zvea/tiny-breakout/tutorials/physical-design.html

Loading the layout…

Scroll to zoom, drag to move, ← → to step/play

# Tiny Breakout physical design

From an empty die to the finished GDS

← Back Next →
