zvea/tiny-breakout/tutorials/asic-toolchain.html

# Tiny Breakout toolchain

Hover or focus a box or an underlined name for a short definition; click or press Enter for details. Escape closes the top popover.

The chart is wider than the screen; scroll it sideways.

## Glossary

Describes the flow as of November 2026: LibreLane 3.0.14 under Tiny Tapeout's sky26e action, sky130, as of commit 2c6b0f6 of tiny-breakout (https://github.com/zvea/tiny-breakout).
