zvea/tiny-breakout/(commit log)

2026-11-06 Real-time browser player; vectorize brick logic
    - sim/play: Verilator 4.x model streamed to a browser page at 60 fps
    (server runs the game, pushes RLE frames; keys sent separately so
    the frame rate is independent of SSH port-forward latency).
    Gamepad input goes through the emulated Gamepad PMOD protocol.
    - project.v: brick select / clear and row/column decoders written as
    whole-vector expressions. Same behaviour (identical output checksum),
    ~1.5x faster simulation, and the re-hardened layout shrank from
    73.4% to 70.5% utilization with no typical-corner slew violations.
    - .gitignore: simulator build output, local toolchains, GDS renders.
2026-11-06 Fix autoplay getting stuck in a closed ball loop
    Autoplay always aimed the ball at the paddle centre, so the bounce angle
    never varied and the ball could settle into a repeating path that missed
    the remaining bricks. Now each paddle hit picks one of four 16 px paddle
    zones from a 5-bit LFSR, which varies the return angle.
    Add sim/play/autoplay_check.cpp: long autoplay run reporting bricks
    cleared, levels and lives lost (30k frames: 2 levels, 0 lives lost).
    Layout: 74.0% utilization, all timing/DRC/LVS/antenna checks clean.
    [project.v]
2026-11-06 Name the magic numbers in the RTL
    Replace bare constants with named localparams: VGA timing (H_*/V_*),
    gamepad button bit positions (GP_*), paddle limits and serve position,
    spare lives, and a colour palette with per-object colour roles.
    Formally equivalent to the previous version (yosys equiv: 355/355
    proven). Synthesis area drops slightly (7726 -> 7714 um^2) because the
    vsync test is now a range compare.
    [project.v]
2026-11-06 Convert the RTL to SystemVerilog
    Rename src/project.v to src/tt_um_tiny_breakout.sv (file named after
    its module) and update info.yaml, test/Makefile and the player build.
    - logic for all variables and ports (reg did not mean "register")
    - always_ff for flip-flops, always_comb for combinational blocks
    - constants sized to the signals they are compared with, so the RTL is
    Verilator -Wall clean; unused bits listed in _unused
    - '1 fill for the gamepad shift register reset
    - wire kept for one-line continuous definitions: "logic x = expr;"
    would be a one-time initialiser
    ALL_BRICKS keeps {48{1'b1}}: yosys's built-in frontend sizes '1 in a
    parameter as a single bit, which the equivalence che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
    [tt_um_tiny_breakout.sv]
2026-11-06 Clearer names and a gamepad button struct
    - hc/vc -> h_pos/v_pos (beam position), with a comment on their ranges
    - hsync_n/vsync_n -> h_sync_n/v_sync_n, hs_q/vs_q -> h_sync_q/v_sync_q
    - Replace the GP_* bit-position constants with a packed struct naming all
    12 buttons in the order the PMOD sends them; list the 7 unused buttons
    in _unused
    - Slice the brick row into vb_low outside the always_comb, which silences
    Icarus's "constant selects in always_* processes" note
    Formally equivalent to the previous version with the renames applied
    (yosys equiv: 355/355 proven); identical synthesis result (7749 um^2,
    1008 cells). Verilator -Wall clean; cocotb tests pass.
    [sim.h, test.py, tt_um_tiny_breakout.sv]
2026-11-06 Describe the pin layouts with packed structs
    - inputs_t names the ui_in pins (direct buttons, autoplay, Gamepad PMOD);
    the code reads ui.left, ui.gp_data etc. instead of ui_in[N]. A comment
    cites the Gamepad PMOD's default pinout for the fixed bits 4..6.
    - tiny_vga_t names the TinyVGA PMOD pins; uo_out is wired field by field
    with continuous assigns (inside always_comb, Icarus treats struct
    fields as part-selects and warns).
    - rgb_t {r, g, b} for the palette, rgb, brick_rgb and rgb_q.
    - Header pin list in bit order, pointing at the structs.
    Formally equivalent to the previous version (yosys equiv: 370/370
    proven); identical synthesis result (7749 um^2, 1008 cells).
    Verilator -Wall c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
    [tt_um_tiny_breakout.sv]
2026-11-06 Simplify gamepad edge detection
    The *_prev registers were a third stage of the clock/latch synchronisers:
    widen gp_clk_s and gp_latch_s to 3 bits and name the edge conditions
    gp_clk_rise and gp_latch_rise.
    Formally equivalent to the previous version (yosys equiv: 380/380
    proven); same flip-flops. Verilator -Wall clean; cocotb tests pass.
    [tt_um_tiny_breakout.sv]
2026-11-06 Round ball and spare-life markers
    A shared function in_circle8 cuts the corners of an 8x8 box into an
    8-px circle (rows 4, 6, 8, 8, 8, 8, 6, 4 px wide). The ball and the
    spare-life markers both use it; collisions follow the round ball shape
    since they are detected by pixel overlap.
    The function assigns its result to its name instead of using "return",
    which the yosys 0.55 frontend does not support.
    Cost: synthesis 7721 -> 7911 um^2 (+14 cells); layout utilization
    74.0% -> 76.1%, all timing/DRC/LVS/antenna/slew checks clean.
    Verilator -Wall clean; cocotb tests pass; rendered frame checked.
    [tt_um_tiny_breakout.sv]
2026-11-06 Group collision flags, loop the brick decoder, name the 8-px grid
    - hit_l/r/t/b/p -> packed struct hit (hit.l, hit.p, ...), cleared with
    a single hit <= '0
    - brick_sel built by a generate loop instead of six copy-pasted terms
    - cell_x/cell_y plus WALL_L_CELL, WALL_R_CELL, WALL_T_CELL,
    PADDLE_CELL_Y and LIVES_CELL_Y replace the bare h_pos[9:3]/v_pos[9:3]
    comparisons; hb/vb -> brick_col/brick_row
    - Drop the redundant autoplay alias; use ui.autoplay directly
    Formally equivalent to the previous version with the hit-flag rename
    applied (yosys equiv: 374/374 proven). Verilator -Wall clean; cocotb
    tests pass.
    [tt_um_tiny_breakout.sv]
2026-11-06 Show spare-life marker i while lives > i
    Replace the two hand-written slot tests with life_slot < lives, where
    life_slot counts 16-px slots from FIRST_LIFE_SLOT (x 64). Raising
    SPARE_LIVES now shows more markers with no other change.
    Verified: equivalent to the previous version everywhere except life_px
    (yosys equiv: 400/401), and a separate SAT proof shows the old and new
    marker tests agree for every h_pos when lives <= 2 (the only reachable
    values; without that assumption the proof fails at lives = 3, x = 96).
    Synthesis +16 um^2 (+3 cells). Verilator -Wall clean; cocotb tests pass.
    [tt_um_tiny_breakout.sv]
2026-11-06 Split the game logic into one block per concern
    Name the per-frame decisions once, in priority order (restart,
    on_paddle, lose_ball, fly) plus touch for scan-out contact, and split
    the single game always_ff into paddle, ball, game progress, bricks and
    collision-flag blocks so each register is written in exactly one place.
    Formally equivalent to the previous version (yosys equiv: 407/407
    proven), so the original priority order is preserved. Verilator -Wall
    clean; cocotb tests pass.
    [tt_um_tiny_breakout.sv]
2026-11-06 Name the ball direction flags for what they mean
    vx_neg/vx_fast/vy_neg -> ball_left/ball_steep/ball_up, the next-state
    wires to next_left/next_steep/next_up/paddle_left, and the per-frame
    steps vx/vy to step_x/step_y. A comment explains why the direction is
    kept as sign and magnitude: it matches how walls, paddle and bricks
    change it. Storing two's-complement velocities instead was tried: same
    behaviour (6000 autoplay frames identical) but +464 um^2 (+6%) of logic.
    (yosys equiv: 388/388 proven); identical synthesis result (7816 um^2,
    1033 cells). Verilator -Wall clean; cocotb tests pass.
    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
2026-11-06 Split out vga_timing and gamepad_rx modules
    - vga_timing: 640x480 @ 60 Hz counters, sync pulses, visible, and a new
    vblank_start strobe (the game's frame_tick)
    - gamepad_rx: synchronisers, edge detection and shift register; outputs
    all 12 named buttons (gamepad_pkg::gamepad_t), all zero without a
    controller. Mapping buttons to "fire" moved into the game.
    - gamepad_pkg: the shared button type. Referred to as
    gamepad_pkg::gamepad_t because the flow's yosys (0.62) does not
    support `import`.
    - ALL_BRICKS back to '1: yosys 0.62 sizes it correctly (0.55 did not).
    - Source lists updated in info.yaml (package first), test/Makefile and
    sim/play/build.sh.
    Verification: yosys equiv proves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
    [gamepad_pkg.sv, gamepad_rx.sv, tt_um_tiny_breakout.sv, vga_timing.sv]
2026-11-06 Add unit tests for vga_timing and gamepad_rx
    cocotb tests run per module through the cocotb runner and pytest:
    pytest test/unit # Verilator (default), ~30 s
    SIM=icarus pytest test/unit # Icarus, as in the Tiny Tapeout CI, ~75 s
    vga_timing: sync pulse widths and periods with their start positions,
    the 640 x 480 visible area, and the vblank_start strobe.
    gamepad_rx: reset state, each button's field, second controller
    ignored, absent controller reads as nothing pressed, outputs change
    only on the latch pulse.
    The frame-level VGA tests wait on signal edges instead of stepping the
    clock from Python. Both simulators pass.
    [cocotb_run.py, test_gamepad_rx.py, test_vga_timing.py]
2026-11-06 Split out the autoplay module, with unit tests
    autoplay holds the LFSR, the aim zone and the steering comparison. Its
    interface takes the ball and paddle x positions in pixels and returns
    steer_left/steer_right; the top level still decides whether autoplay or
    the buttons steer.
    Unit tests (test/unit/test_autoplay.py): steering against a reference
    formula across zones, paddle and ball positions; the zone changes only
    on paddle hits and comes from the random sequence; the sequence visits
    all 31 non-zero values with period 31; every zone gets picked.
    Formally equivalent to the previous version (yosys equiv: 443/443
    proven, registers paired across the new module boundary). Verilator
    -Wall clea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
2026-11-06 Split out the brick_wall module, with unit tests
    brick_wall holds the 48-bit brick state, the field geometry, the
    column/row decoders and the 2-px gaps. Interface: beam position,
    refill and clear in; brick_px, brick_row (0 = top .. 5), over_columns
    and empty out. The game states its brick rules in two assignments, and
    the colour table now reads top to bottom by row index.
    Unit tests (test/unit/test_brick_wall.py): full wall with correct rows
    after reset; gaps and surroundings are not bricks; clearing removes
    exactly the brick under the beam (checked against a model); empty after
    the last brick, then refill; over_columns spans x 64..575.
    Formally equivalent to the previous version (yosys eq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
    [brick_wall.sv, test_brick_wall.py, tt_um_tiny_breakout.sv]
2026-11-06 Reduce area: indexed brick read, shared wall tests, 3-signal gamepad latch
    Measured with the Tiny Tapeout default flow (config untouched); TT
    utilisation 75.33% -> 74.03%.
    - brick_wall: read the brick under the beam by binary index
    ({row, col}) instead of the 48-way one-hot AND-OR.
    - The top wall spans the left wall, the brick columns and the right
    wall, so it reuses those tests instead of two range comparators.
    - gamepad_rx now outputs the report with a one-clock report_valid
    strobe; the game latches only its 3 controls (left, right, fire =
    B | start | A) instead of the receiver latching 5 buttons.
    Tried and rejected (measured worse or no gain): life markers as two
    equality tests,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
2026-11-06 Reorder and rename the top level for clarity
    Sections now follow the data flow: types and pins, video timing, game
    state, controls, what is under the beam, collisions, frame update,
    video output. rgb_t moves to the types; button combining sits with the
    gamepad latch and autoplay.
    Renames for consistency: bx/by -> ball_x/ball_y; pad_q/padx/PAD_*_Q ->
    paddle_q/paddle_x/PADDLE_*_Q; dbx/dby/dpx -> ball_dx/ball_dy/paddle_dx;
    hit.l/r/t/b/p -> hit.wall_l/wall_r/wall_t/brick/paddle; hit_zone ->
    hit_quarter and autoplay's zone -> aim_quarter; serve -> serving;
    gameover -> game_over; wall_*/field -> wall_*_px/field_px (plus
    wall_px); ap_* -> auto_*; paddle_left -> left_after_paddle.
    brick_wall comput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
    [autoplay.sv, brick_wall.sv, test_autoplay.py, tt_um_tiny_breakout.sv]
2026-11-06 Replace white-box sim tools with black-box scenario tests
    test/system/scenarios.cpp drives only the input pins and judges only
    from the decoded video output (life markers, ball, paddle, bricks), so
    RTL refactors cannot break it. Scenarios: launch, steering (direct pins
    and gamepad), paddle limits, game over and restart, autoplay clears a
    level. test_scenarios.py builds it with Verilator (sources from
    info.yaml) and runs each scenario under pytest: pytest test/system
    (about 5 minutes, mostly the autoplay level).
    sim/play/sim.h can now drive the direct button pins.
    Removed sim/harness.cpp (CXXRTL) and sim/play/autoplay_check.cpp: both
    read internal signals by name and had been broken since t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
    [sim.h]
2026-11-06 Split out the tiny_vga_out module, with unit tests
    tiny_vga_out owns the TinyVGA PMOD facts: the pin layout, registering
    all 8 outputs on the same clock edge, and blanking (black outside the
    visible area, which the game's colour priority no longer handles). Its
    colour inputs are three plain 2-bit ports, so it depends on no package
    and can be reused as is.
    Unit tests (test/unit/test_tiny_vga_out.py): all 64 colours land on the
    right pins; blanking forces black while syncs pass through; all sync
    combinations pass through; outputs change one clock after the inputs.
    Formally equivalent to the previous version at every output pin and
    register (yosys equiv: 527/533; the 6 unproven points are the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
    [test_tiny_vga_out.py, tiny_vga_out.sv, tt_um_tiny_breakout.sv]
2026-11-06 Move the colour type and palette into colour_pkg
    colour_pkg holds rgb_t (2 bits per channel) and the 11 named colours.
    tiny_vga_out takes a single colour_pkg::rgb_t port instead of r, g, b,
    so the channels cannot be swapped at the instance. The top level keeps
    only what is the game's: the colour roles, the brick-row colours and
    the drawing priority.
    Formally equivalent to the previous version (yosys equiv: 554/554
    proven); identical synthesis result. Verilator -Wall clean;
    tiny_vga_out unit test passes.
    [colour_pkg.sv, test_tiny_vga_out.py, tiny_vga_out.sv, tt_um_tiny_breakout.sv]
2026-11-06 Speed the ball up as it reaches higher brick rows
    speed_level (0..3) rises to the level of the highest brick-row pair the
    ball has cleared a brick in (rows 4-5, 2-3, 0-1 -> 1, 2, 3: the
    inverted top two bits of brick_row) and returns to 0 whenever the ball
    is back on the paddle (new ball, level or game). On average
    speed_level frames in 4 the ball moves twice its step (a shift), giving
    1x, 1.25x, 1.5x, 1.75x; steps stay even and at most 4 px.
    The LFSR moved out of autoplay into a new frame_rng module, shared by
    autoplay's aim (bits 1:0) and the speed rhythm (bits 3:2). autoplay now
    takes its random bits as an input.
    Tests: autoplay unit tests drive the random input; new frame_rng unit
    test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
    [autoplay.sv, test_autoplay.py, tt_um_tiny_breakout.sv]
2026-11-06 Toggle autoplay with the gamepad's SELECT button
    Each press of SELECT (released in the previous report, pressed in this
    one) switches autoplay on or off; holding it counts as one press. The
    direct AUTOPLAY pin still works: autoplay = pin OR gamepad toggle. Two
    flip-flops: the latched SELECT and the on/off state.
    New select_toggles_autoplay scenario: holding SELECT switches autoplay
    on once (it launches the ball); a second press switches it off (the
    paddle stays put without input).
    Verified: Verilator -Wall clean. TT utilisation 75.11% -> 76.46%, more
    than two flip-flops would suggest; not yet investigated.
    Not yet run: the unit tests and the scenarios (also still pending for
    the speed-up c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
    [tt_um_tiny_breakout.sv]
2026-11-06 Faster speed-up without the LFSR; bounce off brick sides
    Speed: the ball and the paddle now move 1, 2 or 3 times per frame, by
    their usual step, at the start of lines 480, 481 and 482 (vertical
    blanking). Twice per frame after the current ball has cleared 4
    bricks, three times after 8; back to once per frame when the ball is
    on the paddle. This replaces the row-based 1x..1.75x rhythm: higher top
    speed, faster progression, even motion, and no step scaling or paddle
    clamp arithmetic.
    No more LFSR: frame_rng and its tests are gone. Autoplay moves its aim
    on by 1 or 2 paddle quarters on each paddle hit, chosen by ball_x[2].
    The paddle re-decides before every 4-px move, so it stops exactly on
    ta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
    [autoplay.sv, test_autoplay.py, tt_um_tiny_breakout.sv]
2026-11-06 Keep the brick wall as a ring that turns with the beam
    The bricks are stored in the order the beam meets them, so the brick
    under the beam is always bricks[0][0]: no 48-way read multiplexer, no
    write decoder, and clearing touches one bit. The head row turns by one
    brick at the start of each brick column (8 turns per line); all rows
    turn by one row at the start of each brick row (6 per frame). Each
    brick bit becomes a single enable flip-flop.
    Refill shifts 1s in with the row turns of the next frame, so the 48
    bits need no reset; the bricks stay hidden until the last turn (only
    the bottom row shows for that one frame), which also keeps the
    unreset bits from showing as X in simulation. Empty i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
    [brick_wall.sv, brick_wall_tb.sv, test_brick_wall.py]
2026-11-06 Trim the gamepad receiver
    - The shift register has no reset; instead the first report after
    reset is not presented (it may have started before reset ended), so
    every presented report is complete. Each shift bit is now a single
    enable flip-flop instead of a flip-flop plus reset/enable logic.
    - No controller is detected as up and down pressed together (a d-pad
    can't), instead of all 12 bits being ones.
    - report_valid is the synchronised latch level (a few clocks) rather
    than its rising edge, saving the edge-detect flip-flop. The top
    level's SELECT edge detection already ignores a held level.
    - The data synchroniser stays: the reference driver samples data at
    the same delay as the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
    [gamepad_rx.sv, test.py, test_gamepad_rx.py, tt_um_tiny_breakout.sv]
2026-11-06 Five behaviour-preserving area savings in the top level
    - Walls: whether the ball touches the left, right or top wall follows
    from its position (x <= 63, x + 7 >= 576, y <= 31: its round shape
    reaches its box's edges), checked at frame_tick like the flags were.
    Three collision flags go.
    - ball_y is always even and below 512: only y / 2 is stored (8 bits).
    - Game over is lives == 3: losing a ball with none left wraps lives
    from 0 to 3. The game_over flip-flop goes.
    - Life markers sit in two fixed slots instead of a slot subtraction
    and comparison.
    - The speed counter stops when bit 3 is set (8) instead of comparing.
    Measured in local synthesis (sky130, mean of 5 register orderings)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
    [tt_um_tiny_breakout.sv]
2026-11-06 Add half speed steps: 1x, 1.5x, 2x, 2.5x, 3x
    The speed still goes up every 4 bricks the current ball clears, now by
    half a step: 1x, 1.5x, 2x, 2.5x, then 3x after 16 bricks. A half step
    alternates frames (1.5x: 1, 2, 1, 2 ... moves per frame; 2.5x: 2, 3),
    using a new odd_frame flip-flop:
    moves = 1 + speed_level[4:3] + (speed_level[2] & odd_frame)
    speed_level grows to 5 bits and stops at 16. At most 3 moves per frame
    as before, so collisions and the blanking-line timing are unchanged.
    ball_speeds_up checks every step: 2, 2|4, 4, 4|6 and 6 px per frame
    vertically, the half steps alternating from frame to frame.
    Verified: Verilator -Wall clean; ball_speeds_up (frames checked at
    1x/1.5x/2x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
    [tt_um_tiny_breakout.sv]
2026-11-06 Add an optional score (ENABLE_SCORE, off by default)
    score: a 3-digit decimal (BCD) counter, one point per brick, shown as
    four seven-segment digits with a fixed last 0 (arcade style: a brick
    reads as 10, up to 9990), white, top right at x 512..575. It goes back
    to 0000 when a new game starts and stays visible through game over.
    It costs about 8.3 TT utilisation points (71.70% -> 80.00%, mean of 3
    orderings), so it is behind a top-level parameter, ENABLE_SCORE,
    default 0: the Tiny Tapeout wrapper builds without it, and synthesis
    then drops the module (same area as before, within a gate).
    Simulators can enable it: Verilator -GENABLE_SCORE=1, Icarus -P;
    ENABLE_SCORE=1 for sim/play/build.sh an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
    [score.sv, test_score.py, tt_um_tiny_breakout.sv]
2026-11-07 Level progression, LFSR autoplay, demo while no controller is connected
    Level cleared:
    - The empty field stays for about half a second before the next wall
    (speed_level doubles as the timer: 16..31 on odd frames).
    - A spare ball back, up to 2.
    - Each level's balls start a half step faster (level 0..3: 1x, 1.5x,
    2x, 2.5x); losing a ball returns to the level's starting speed. A
    2-bit level counter, staying at 3.
    Autoplay: the aim quarter comes from a 5-bit LFSR again (stepping every
    frame). Picking it from the game's own state (ball_x[2]) let the game
    fall into loops that never cleared the last bricks; the new
    level_cleared scenario got stuck that way.
    Demo: with no controller connecte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
    [autoplay.sv, gamepad_rx.sv, sim.h, test.py, test_autoplay.py, test_gamepad_rx.py, tt_um_tiny_breakout.sv]
2026-11-07 Review fixes: comments, names, resting ball, pin-only TT test, docs
    From a review of the whole codebase:
    - Comments: corrected where they no longer matched the code (moves per
    frame, the demo's actual rules, frame-update timing, autoplay can
    repeat a quarter, brick cells vs bricks, refill timing), and
    shortened or clarified the rest.
    - Names: SCREEN_HEIGHT, paddle_x4 (and ball_x4/aim_x4 in autoplay;
    _q is reserved for register outputs), level_done/level_next.
    SPARE_LIVES and the right wall's position replace literals;
    brick_wall names its first column and row. new_game is declared
    before use.
    - Bug: the ball resting on the paddle was placed once per frame from
    the paddle posi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
    [autoplay.sv, brick_wall.sv, colour_pkg.sv, gamepad_pkg.sv, gamepad_rx.sv, score.sv]
2026-11-07 Find the ball's box by racing the beam instead of subtracting
    The ball's 8x8 box was found with two 10-bit subtractions (h_pos -
    ball_x, v_pos - ball_y) at every pixel. Now it starts where the beam
    meets the box's corner (h_pos == ball_x, v_pos == ball_y) and lasts
    until the 3-bit offset in the box wraps to 0, with one flip-flop per
    axis holding the previous clock's state (reset, so Icarus sees no X).
    The 3-bit offsets still drive the circle test and the brick-edge
    classification. Idea and first version from the visuals exploration.
    Saves 179 um2 in local synthesis (mean of 5 register orderings, 8268 ->
    8090), about 1.6 TT utilisation points.
    Verified: Verilator -Wall clean (with and witho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
    [tt_um_tiny_breakout.sv]
2026-11-07 Count gamepad bits instead of shifting; SELECT turns autoplay on
    gamepad_rx keeps a 5-bit index of the report bit (held at 0 by the
    latch, waiting at 31 after reset until the first latch, so a report
    under way at reset is ignored) and catches each button the game uses
    straight into its own flip-flop at its index: connected (up and down
    together means no controller), left, right, fire. The 12-bit shift
    register, the first-report logic and the top level's latched copies
    go. gamepad_pkg now holds the report's bit indices instead of the
    report struct.
    Controls change (agreed):
    - Fire is A, X, L or R (one run of bits, cheaper than B/START/A).
    - SELECT switches autoplay on; left, right or fire sw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
    [gamepad_pkg.sv, gamepad_rx.sv, serve.cpp, test_gamepad_rx.py, tt_um_tiny_breakout.sv]
2026-11-07 Route with a 10% global-router reserve instead of 30%
    GRT_ADJUSTMENT 0.1 in src/config.json. The global router held back
    30% of each metal layer's tracks; designs from ~77% TT utilisation
    overflowed (180 overflows at 77.8%) and detailed routing did not
    converge. With 10%, full hardens routed clean (0 DRC, 0 LVS, 0
    antenna, timing met): 1636bbd at 77.2%, and the current code with
    ENABLE_SCORE=1 at 80.7%. The detailed router has more to clean up but
    gets there; the final checks are the judge. The setting only affects
    this tile's own routing.
2026-11-07 Add tools/: flow, utilisation, local area and equivalence scripts
    The measuring and checking scripts used during development, made
    location-independent (repo found from the script's path, sources from
    info.yaml, the sky130 library from $PDK_ROOT or ~/.ciel):
    - flow.sh place|harden: the TT flow up to global placement (TT's
    utilisation) or in full (DRC, LVS, antenna, timing, GDS); EXTRA_CFG
    overrides settings for experiments.
    - flow_avg.sh: TT utilisation averaged over 3 register orderings.
    - local_area.sh: local synthesis area of the working tree vs a git
    revision, 5 orderings each.
    - equiv.sh: formal equivalence of the working tree vs a git revision
    (now maps memories first, as the s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
2026-11-07 Remove the ENABLE_SCORE build toggle
    The score is always built now. The scenario tests check it
    unconditionally, and sim/play/build.sh and test_scenarios.py no longer
    read ENABLE_SCORE from the environment.
    Verified: formally equivalent to the previous commit (tools/equiv.sh,
    551/551 proven, with the score's register renamed from
    g_score.u_score.digits to u_score.digits); Verilator 5 -Wall clean;
    the game-over scenario, which checks the score, passes.
    [tt_um_tiny_breakout.sv]
2026-11-07 Tidy up after a project audit
    Document how to set up the toolchain and run each test layer, run the
    unit tests in CI, and fix the gamepad receiver's unit tests, which had
    been failing on Icarus. Also remove leftovers and fix stale or
    inconsistent comments and docs. The hardware is unchanged (formally
    equivalent to the previous commit).
    [cocotb_run.py, serve.cpp, tb.v, test_gamepad_rx.py, tiny_vga_out.sv, tt_um_tiny_breakout.sv]
2026-11-07 Fix findings from a pre-publication review
    Correct the datasheet's paddle angle (the ends send the ball off
    flatter, not steeper) and the matching RTL names, move the router
    setting above the template's "do not change" banner, document how to
    set up hardening, and tidy smaller inaccuracies in comments and docs.
    The hardware is unchanged (formally equivalent to the previous commit).
    [serve.cpp, sim.h, test.py, tt_um_tiny_breakout.sv]
2026-11-07 Add tools/lec.sh: prove the hardened netlist implements the RTL
    LVS only checks the layout against the netlist; nothing checked the netlist
    against the RTL, which matters now that synthesis settings have changed.
    lec.sh models the cells from the sky130 Liberty file, pairs registers by
    name and proves every register and output equivalent with yosys. flow.sh
    harden runs it and fails if it fails.
2026-11-07 Stop the resizer using clock delay cells as ordinary buffers
    sky130's place-and-route exclusions leave most clkdlybuf4s* delay cells
    available, and the resizer chose clkdlybuf4s25_1 for 51 fanout and input
    buffers. Excluded, it uses buf_1: about 290 um2 less area, 9% less wire,
    and 0 DRC, LVS and antenna errors with the netlist proven equivalent.
2026-11-07 Use small clock buffers
    The clock tree's leaf buffers take the root buffer's type, so the default
    clkbuf_16 root gave 32 clkbuf_16 leaves driving 5-6 flip-flops each: 1,076
    um2 of clock tree. clkbuf_4 and clkbuf_2 need about 400 um2. Hardened with
    the previous commit: 7% less standard-cell area, 22% less wire, 0 DRC, LVS
    and antenna errors, no clock-pin slew violations, netlist proven equivalent.
2026-11-07 Show the web player's game speed
    Below 60 fps the player doesn't skip frames: it simulates every one, so the
    game runs in slow motion. The status line now says how fast it runs relative
    to the hardware, so timing isn't misjudged in a slow sim.
    [serve.cpp]
2026-11-07 Light the border red as a lost ball falls
    Once the ball's top is below the paddle (y >= 456) nothing can send it back
    up. Until it leaves the screen the black border turns red, a shade brighter
    for each 8-px band it falls (maroon, dark red, red), so the pulse keeps pace
    with the ball. No new state: it comes from ball_y and ball_lost.
    Hardened: +74 um2 (80.4% to 80.8% utilisation), 0 DRC, LVS and antenna
    errors, netlist proven equivalent. A new scenario checks the border's colour
    against the ball's height in every frame.
    [tt_um_tiny_breakout.sv]
2026-11-07 Bring the README's figures and layout picture up to date
    The smaller clock buffers and resizer buffers brought the transistor count
    down to about 15,600, and the picture showed an older layout. The player
    paragraph no longer promises 60 frames a second: it simulates every clock,
    so on most machines the game runs slower than on the chip.
2026-11-07 Bring a curtain down at game over, leaving the score
    A black curtain comes down from the top, 16 px a frame (half a second to the
    bottom), over everything but the score. speed_level, idle after game over,
    holds its line: a lost ball resets it, and game over counts it up to 31.
    Hardened: utilisation 80.8% to 81.5%, 0 DRC, LVS and antenna errors, netlist
    proven equivalent. A new scenario follows the curtain frame by frame and
    checks that only the score is left and that a new game restores the picture.
    [tt_um_tiny_breakout.sv]
2026-11-08 Halve the speed of the ball and paddle
    Moves are spread over a 4-frame cycle: 2, 3, 4, 5 or 6 per 4 frames for 1x to
    3x, half the old rate (a 2-bit frame_phase replaces odd_frame). The direction
    now takes in each frame's collisions at frame_tick even in a frame without a
    move; otherwise a cleared brick's bounce was lost and the ball ploughed on.
    Hardened: utilisation 81.5% to 82.4%, 0 DRC, LVS and antenna errors, netlist
    proven equivalent. The scenarios check the speeds over 4-frame windows and wait
    up to two frames for a new ball to settle; test.py compares the paddle two
    frames apart. The README's figures and layout picture are brought up to date.
    [test.py, tt_um_tiny_breakout.sv]
2026-11-08 Stop the score at 9990 instead of wrapping to 0000
    A score that drops to 0000 looks like a fault; one that stays at 9990 reads as
    maxed out. The counter now ignores points once all three digits are 9, which
    reuses the carry logic's tests (about 6 um2). A new game still clears it.
    Hardened: 0 DRC, LVS and antenna errors, netlist proven equivalent; the score
    unit tests check the cap and the clear.
    [score.sv, test_score.py]
2026-11-08 Move the ball with one shared adder and an XOR incrementer
    The ball was placed on the paddle (paddle x + 28) and moved in flight
    (x + step) by two separate adders; now the operands are chosen first and
    added once. ball_y_half's -1 / +1 step becomes an incrementer between XOR
    gates (~(~y + 1) = y - 1). Both mean exactly the same as before: tools/equiv.sh
    proves the design equivalent to its parent.
    Synthesis builds them smaller. Measured: utilisation 82.0% to 80.2% in the
    harden (0 DRC, LVS and antenna errors, netlist proven equivalent, no new
    warnings); in isolation about 90-190 um2 of the saving is structural, the rest
    comes from how the whole netlist then synthesises and may shrink with la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
    [tt_um_tiny_breakout.sv]
2026-11-08 Check the flow's warnings after every harden
    tools/warnings.sh prints the counts of the warnings the flow reports but
    does not fail on, fails on an inferred latch, a critical disconnected pin
    or a clock pin over its slew limit, and lists any kind of message in
    warning.log that tools/warnings.ref does not have. flow.sh harden runs it
    alongside lec.sh.
2026-11-08 Grow each wall after the first from a random seed row
    The first wall of a game stays full. Each later wall is built as the
    ring fills: the first row turn loads a seed row of 4 bricks from the
    LFSR, mirrored into 8 columns, and each later turn loads a row grown
    from the one before it by a cellular automaton (rule 150, or rule 182
    when the LFSR's top bit is set). The 31 LFSR values give 21 different
    symmetric walls of 20 to 48 bricks.
    The LFSR moves out of autoplay into its own module, as the wall now
    uses it too; autoplay aims exactly as before.
    Measured cost: +0.38 points of utilisation in the flow (80.17% ->
    80.55%, within its noise), about +100 um2 in paired local synthesis,
    no new flip-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
    [autoplay.sv, brick_wall.sv, brick_wall_tb.sv, lfsr.sv, test_autoplay.py, test_brick_wall.py, test_lfsr.py]
2026-11-08 Let synthesis use sky130's drive-strength-1 cells
    The PDK's default synthesis exclusion list bans the plain _1 cells
    (nand2_1, a21o_1, dfxtp_1, ...) because their small pins can be hard to
    route, so every gate was a _2 cell. src/synth_excluded.cells is that list
    without them; the special _1 cells (clock, delay, scan, low-power) stay
    excluded, and synthesis still honours the PDK's list of cells with layout
    problems. Upstream open_pdks has since dropped the _1 cells from its
    list too.
    Harden of the same RTL: TT utilisation 80.55% -> 60.95%, synthesis area
    11,142 -> 8,640 um2, 15,566 -> 11,720 transistors; worst setup slack 22.6
    -> 26.1 ns, hold delay cells 137 -> 113, max slew warnings 428 ->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
2026-11-08 Celebrate a cleared wall with rising rainbow bands
    The pause after a cleared wall now lasts about a second (its timer steps
    every 4th frame instead of every other), and while it runs, rainbow bands
    in the brick colours, then magenta and rose back to red, rise 2 px a frame
    over the field and the border, behind the ball and paddle. The band under
    the beam is the line plus a count of the pause's frames; the brick colour
    table supplies its colour.
    The scenarios read a brick as standing when it differs from the gap at its
    left edge, rather than from the field colour, which holds while the field
    is a rainbow; level_cleared checks the longer pause and the rainbow.
    Measured cost: +1.26 points of T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
2026-11-08 Narrow the paddle each level instead of speeding up the serve
    The paddle is 96 px wide on a game's first level, then 80, 64, and 48
    from the 4th level on, and every ball starts at 1x (the speed still rises
    with the bricks the ball clears). The paddle is now stored by its centre,
    so it narrows evenly from both ends, the resting ball sits at a fixed
    offset from it, and the angle zones are measured from it: the outer 16 px
    at each end are flat, the half sets the direction, as on today's 64-px
    paddle. Its wall stops depend on the width, and a new game re-centres it,
    as it widens again. Autoplay aims at the middle of each zone, scaled to
    the width.
    The scenarios read the paddle's width off the p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
    [autoplay.sv, test_autoplay.py, tt_um_tiny_breakout.sv]
2026-11-08 Aim autoplay with the pixel that decides the paddle zone
    A bounce takes the zone under the last ball pixel to touch the paddle,
    the right end of the ball's bottom row (ball x + 5), not the zone under
    the ball's centre. Autoplay steered the centre to within 4 px of a zone's
    middle, which on the 48-px paddle put the deciding pixel in the next inner
    zone for one alignment in four. It now steers that pixel, which always
    lands inside the chosen zone; the unit test checks this at every width.
2026-11-08 Start a new game from the reset state of the ball, paddle and speed
    At a restart, speed_level stayed at 31 from the game-over curtain: no
    branch of its update fires while game_over is still set. So the first
    frame of the new game drew the level-clear rainbow over the whole screen,
    and its moves ran at 3x. Separately, when a new game began with the ball
    on the paddle (the demo ending in a pause), the paddle went back to the
    centre while the ball was placed from its old position, off the paddle for
    a frame.
    A new game now resets the paddle, the ball and speed_level as reset does,
    in the same clock: the paddle centred, the ball resting on it, 1x. The
    restart scenario checks the border on each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
    [tt_um_tiny_breakout.sv]
2026-11-08 Ignore SELECT-autoplay while no controller is connected
    With the Gamepad PMOD plugged in but no controller, each report is all
    ones, so the receiver's select_autoplay is set at the SELECT bit and
    cleared at the LEFT bit. A frame update in between saw autoplay on, and
    with it fire: for a player on the direct buttons, the ball launched by
    itself and the paddle steered for a frame. It is now masked with
    connected, like left, right and fire.
    The simulator's PMOD reports could only start at the top of a frame, so a
    frame update never fell inside one. sim.h now takes a start clock, and the
    demo scenario has a case with the reports across the frame update; it
    failed before the fix.
    [gamepad_rx.sv, sim.h, tt_um_tiny_breakout.sv]
2026-11-08 Correct three comments in the top level
    The rainbow bands are 64 px tall, not 32 (the band counter is in 2-px
    lines); the ball's directions are set by every wall and flipped by
    bricks either way, not only as the old comment said; and paddle_dx[3] is
    used now, so only [2:0] go in the unused list.
    [tt_um_tiny_breakout.sv]
2026-11-08 Make the tools work across source-list changes and from any directory
    local_area.sh and equiv.sh read the old revision's files from the working
    tree's source list, so they failed once a file was added (lfsr.sv); each
    side now uses its own info.yaml. The register-ordering swap still looked
    for paddle_x4 and now takes paddle_c4 as well, so local_area.sh works on
    the current tree and on revisions before the change. sim/play/build.sh
    works from any directory.
2026-11-08 Go back to the flow's default routing reserve
    GRT_ADJUSTMENT 0.1 let the global router plan with 90% of each layer's
    tracks instead of 70%: at 77-80% utilisation the design did not route
    with the default. At today's ~65% it is not needed. A harden of the same
    RTL with the default 0.3 had no global-routing overflow (38.6% of tracks
    used), reached 0 detailed-routing violations in one more pass, and was
    clean on DRC, LVS, antenna, timing, warnings and LEC, with slightly
    shorter wiring. The default leaves more room for the detailed router. If
    utilisation nears 75-80% again and routing struggles, this is the first
    setting to revisit.
2026-11-08 Go back to the flow's default synthesis strategy
    AREA 2 replaced the default AREA 0 because, at ~80% utilisation, AREA 0's
    netlist got stuck in detailed routing. Since synthesis can use the _1
    cells the design is at ~65%, and the two strategies come out the same:
    mean TT utilisation over 3 orderings 64.84% (AREA 0) against 64.86%
    (AREA 2), synthesis area within 20 um2. A harden with AREA 0 routed to 0
    violations and was clean on DRC, LVS, antenna, timing, warnings and LEC.
    If utilisation nears 80% again and routing struggles, this and the
    routing reserve are the settings to revisit.
2026-11-08 Update the README's transistor and cell counts
    From the harden of the current design and configuration: 12,508
    transistors in 1,366 standard cells (fill, tap, decap and diode cells
    not counted), with 165 flip-flops.
2026-11-08 Write the move count without widening casts, so lint is clean
    CI's new lint step (Ubuntu's Verilator 5.020) failed on four WIDTHEXPAND
    warnings in the moves-per-frame formula, the same four Verilator 4 has
    always reported: casts like 2'(speed_level[3] & odd_frame) widen the
    AND's operands before the AND. Each term is now zero-extended with
    {1'b0, ...} instead. Proven equivalent to the previous RTL (equiv.sh);
    both local Verilators now lint the design with no warnings.
    [tt_um_tiny_breakout.sv]
2026-11-08 Add tools/walls.sh, to see every wall a layout builds
    It compiles wall_pattern.sv with Verilator into a small harness that
    builds every wall at every level and LFSR value the way brick_wall does,
    then prints each different wall once with the inputs that give it and its
    brick count, and a summary (different walls, overall and per level; the
    fewest and most bricks). It fails if any wall is empty. --png draws them
    as the top of the game screen. About 15 s.
    tools/README.md says how to try a new layout: edit wall_pattern.sv, look
    at its walls with walls.sh, check its cost with local_area.sh and the
    unit test, then play it.
    [wall_pattern.sv]
2026-11-08 Keep autoplay from racing the paddle across while the ball waits on it
    In the second's pause after a cleared wall the ball rests on the paddle,
    and autoplay kept steering to put it over its chosen zone. But the resting
    ball is placed at the paddle's centre and moves with it, so it never
    arrives: autoplay drove the paddle across the field to a wall, 6 px a
    frame. Autoplay now leaves the paddle where it is while the ball rests on
    it; it launches the ball as soon as it may and steers once it flies.
    level_cleared moves the paddle off the wall by hand at the start of the
    pause, then hands it back to autoplay, and checks it stays put. On the
    old RTL the paddle raced off at once.
2026-11-09 Play the Audio Pmod's output in the web player
    The player now streams sound with the picture, for a design that drives
    the Tiny Tapeout Audio Pmod on uio[7]. sim.h models the Pmod as heard from
    its jack: the pin sampled every clock, decimated to 48 kHz, AC-coupled
    (capture_audio, off by default, so the tests don't pay for it).
    On a machine that simulates slower than real time, the server stretches
    each frame's audio to the time the frame really took, at its true pitch
    (sim/play/stretch.h, WSOLA), so the sound stays continuous and in step
    with the slow-motion picture instead of stuttering. The page resamples
    to the browser's own audio rate and holds its buffer near 60 ms, so the
    delay can't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
2026-11-09 Add sound effects for the Audio Pmod, built with the define TB_SOUND
    src/sound.sv plays effects on uio[7] through two voices that take turns
    clock by clock: a marimba-like note per brick (pentatonic, higher rows
    higher), a thock for the paddle, a dull rumble for the walls, a minor sigh
    for a lost ball, a fanfare in the pause after a cleared wall, a sad
    trombone for the last ball and two chords at a new game. Notes are square
    waves that flip every N lines; volumes are pulse-width modulated; noise
    comes from a 9-bit LFSR.
    It is built only with TB_SOUND: the standard build is unchanged, proven
    equivalent to the previous RTL (equiv.sh). With it, TT utilisation is
    83.05% (mean of 3 orderings) ag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
    [sound.sv, test_sound.py, tt_um_tiny_breakout.sv]
2026-11-09 Keep the new-game chord's upper voice playing, and build under Icarus
    Voice B's frame timer stuck at 4 after its first thump or rumble and a new
    game didn't reset it, so the chord's upper notes stopped within a few
    frames: G5 was cut short and E6 never played. The chord now lasts as long
    as voice A's lower notes and ends in the same frame, not a frame later,
    when its volume, taken from voice A's timer, would have blipped at 6.
    test_sound checks both voices on every frame of the chord; it failed on
    the old RTL.
    Icarus, which CI runs the unit tests on, refused two assignments that
    picked an enum value with ?:; they are if-else now.
    [sound.sv, test_sound.py]
2026-11-09 Shrink the sound by 1.7 points without changing what it plays
    Four approaches were explored in parallel; these held up:
    - Simpler end-of-sound tests that use the timers counting up from 0, and
    voice B's note and tone counter narrowed to 5 bits (its notes are at
    most 20, which synthesis couldn't work out). Proven bit-exact.
    - Noise from a hash of the line number and the game's per-frame random
    number instead of a 9-bit LFSR: as white (band levels within 1 dB of
    the LFSR's), varying frame to frame where the LFSR repeated every 511
    lines (a faint 62 Hz buzz), and the rumble still changes every 8 lines.
    - The top level's pause_step multiplexer dropped: the fanfare reads
    speed_level[3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
    [sound.sv, test_sound.py, tt_um_tiny_breakout.sv]
2026-11-09 Keep the player's sound from falling further behind the longer it runs
    The server set the stretch ratio from the frame times alone, clamped at
    1. At full speed a late frame is followed by an early one, which the
    clamp ignored, so the ratio averaged 1.02-1.05: the stretcher used its
    input a few percent slower than the model made it, and the rest waited
    as delay, growing by 1.5-3.5 s a minute in a model of the loop.
    The ratio is now corrected both ways: input waiting beyond what the
    frame's grains need lowers it, and output still owed from earlier
    frames raises it. In the model the delay holds at 40-70 ms at 60 fps,
    and on a slow machine the output no longer falls half a second behind
    and res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
    [serve.cpp, stretch.h]
2026-11-09 Make the player's sound control a mute button
    The "Turn sound on" text button is now a speaker icon, crossed out while
    muted, with a "Mute (M)" or "Unmute (M)" tooltip, and screen readers get
    a Mute toggle that reads as on or off. The key hint says "M mute" or
    "M unmute" as it stands, and the volume slider is greyed out and
    disabled while muted.
2026-11-09 Route the sound build with a 10% reserve and AREA 1 synthesis
    The build with sound (TB_SOUND), at ~81% TT utilisation, did not route
    with the defaults: detailed routing got stuck at ~4,600 violations.
    GRT_ADJUSTMENT 0.1 lets the global router plan with 90% of each layer's
    tracks instead of 70%, and SYNTH_STRATEGY "AREA 1" uses ABC's AREA 1
    script instead of AREA 0. Hardened with both, it routed with 0 DRC,
    LVS and antenna errors at 80.39%, setup slack +25.0 ns, hold +0.12 ns
    (with the reserve alone: also clean, at 81.21%).
    The config applies to the standard build too, at ~65%; it routed with
    the defaults and has yet to be hardened with these settings.
2026-11-09 Always build the sound
    The sound was built only with the define TB_SOUND. It is now part of
    the design: uio[7] is always the Audio Pmod's output, and the other uio
    pins stay inputs. The config's routing settings (10% reserve, AREA 1)
    were chosen for this build, which hardened clean at 80.39%.
    The `ifdef and its silent `else go from the top level; CI lints the one
    build; sim/play/build.sh drops SOUND=1; info.yaml names the pin "audio"
    and mentions sound in its description; docs/info.md, the README and
    tools/README.md no longer call the sound optional, and the README says
    how the sound fits in the tile. Lint is clean under Verilator 4.228 and
    5.054; the unit tests, test.py and the 13 system s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
    [sound.sv, tt_um_tiny_breakout.sv]
2026-11-09 Update the README's transistor and cell counts
    From the harden with sound and the current configuration: 15,204
    transistors in 1,722 standard cells (fill, tap, decap, diode and tie
    cells not counted), with 197 flip-flops.
2026-11-09 Silence the new-game chord's upper voice on the frame it ends
    Voice A goes silent on the frame its sound ends, but voice B's chord
    volume was worked out separately, as 6 minus the timer's bits, which
    wrap back to 6 on that frame: the chord faded to 3 and ended with 17 ms
    of E6 at volume 6. Voice B now takes voice A's volume while A plays the
    start chord, and is silent otherwise. The chord test now also checks
    the frame they end, and fails on the old RTL (B at volume 6).
    [sound.sv, test_sound.py]
2026-11-09 Keep the sound buffer's delay low after a burst that laps it
    The player's AudioWorklet writes incoming samples into a 1 s ring with no
    overrun check, and measures its fill modulo the ring's length. A burst of
    more than 1 s (a main-thread or network stall releasing) laps the reader,
    so the ring looks only partly full: the jump for a far overfull buffer
    doesn't fire, and the 1% speed-up takes 15 s or more to bring the delay
    back down. Now a write that would fill the ring moves the read position
    to the target delay behind the new write position, as the overfull jump
    does.
    Checked with a node emulation that runs the worklet source from
    index.html: a steady 48 kHz feed, a 1.25 s stall, then a bu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
2026-11-09 Keep the browser's sound continuous at low frame rates
    Below 60 fps the server sends each frame's audio stretched to the time
    the frame took, all at once: 8000 samples a frame at 6 fps. The worklet
    held its instantaneous fill near 60 ms, so on average the buffer sat at
    60 ms and its low point, just before the next frame's samples arrived,
    went dry: a short gap every frame or two below about 8 fps. And its
    overfull jump fired whenever the fill passed 240 ms, which at 4 fps is
    every frame (12000 samples arrive on top of what is left), so most of the
    sound was thrown away.
    Now the worklet measures the fill when samples arrive (the low point of
    the sawtooth), holds that near 60 ms with the same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
2026-11-09 Stretch the sound down to 3.75 fps, and describe the correction right
    The server clamped the stretch ratio at 8, both the smoothed ratio and the
    corrected one passed to the stretcher, so below 7.5 fps a frame's 800
    samples could not cover the time it took: the output fell behind, the
    half-second resync kept dropping the debt, and the sound stuttered. Both
    clamps are now 16, enough down to 60/16 = 3.75 fps. The header claimed
    the sound plays continuously however fast the CPU, which was never true;
    it now states the floor.
    The comment on the correction said each 0.5 s of input waiting halves
    the ratio and each 0.5 s of output owed doubles it, which reads as
    exponential; it divides by 1 + wait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
    [serve.cpp]
2026-11-09 Stop a tab that another tab has taken the stream from
    The server streams to one viewer at a time and a new /stream replaces
    the old one by closing its connection. The old tab saw the stream end,
    took it for a dropped connection and reconnected a second later, taking
    the stream back; two open tabs swapped it every second for as long as
    both stayed open.
    Now the server sends the replaced viewer a last header with video length
    0xFFFFFFFF and no samples before closing it (non-blocking, best effort,
    so a stalled old viewer can't hold up the new one). The page treats that
    as the end: it says it was taken over by another tab and to reload to
    watch there, stops reconnecting, and stops sending keys,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
    [serve.cpp]
2026-11-09 Send key changes to the server in order
    Each key change went out as its own /keys request, all of them at once,
    and the server applies whichever arrives last. Over a slow or jittery
    link (an SSH port forward, say) a quick burst of changes could arrive out
    of order and leave the game with a stale state: a paddle that keeps
    moving after the key is up, or stops while it is held.
    Now the page sends one request at a time, each after the last has
    finished; changes made meanwhile are sent as one, the newest state, with
    a pending reset (bit 16, an event rather than state) carried until it is
    sent. A request that hangs is given up after 2 s, so a stalled link
    can't block the keys for good. The serve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
2026-11-09 Drop the unused span around the mute key hint
    The help line wrapped the M key hint in <span class="snd">, but no style
    or script refers to a snd class (the sound controls use the snd id), so
    the span did nothing. Removed it, keeping its content.
    Checked with a search of the repository for the class, and with
    Playwright: the page's help line reads the same, and the M hint still
    switches between unmute and mute.
2026-11-09 Say why the flow scripts stop instead of dying silently
    Both scripts run under set -euo pipefail, and both had a pipeline whose
    failure ended the script with nothing said. flow_avg.sh piped flow.sh
    into grep, so when a flow failed, flow.sh's "FLOW FAILED (see log)"
    went into the pipe, grep found no number, and flow_avg.sh exited 1
    without saying which ordering failed or where the log was. flow.sh
    took TT's utilisation from the GPL-0019 line with grep | head | sed, so
    a log without that line ended it before the report, including the
    harden checks.
    Now flow_avg.sh captures flow.sh's output; if flow.sh fails, or prints
    no utilisation, it says which ordering and prints that output (which
    names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
2026-11-09 Listen to the audio pin in the system tests
    The scenarios judged only the picture, so nothing checked the sound
    through the chip's pins: the unit test drives sound.sv's ports, and the
    wiring into it in the top level went untested. sim.h now counts, for
    each line, the clocks the audio pin is high on odd and on even h (voice
    A and voice B take turns clock by clock), and the scenarios read each
    voice's volume and note from that: a sounding voice is high for 50 x
    its volume clocks of a line, and a note is the length of its square
    wave's runs of high and low lines.
    A new scenario, sound, hears a new game's two chords on both voices (8
    and 24 frames, then quiet), the thock over the thump at each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
2026-11-09 End the cleared-wall fanfare with the pause
    On the frame update that ends the pause, paused is still set, so voice
    A stayed on the fanfare, while the same update put the pause timer back
    to 0: the frame after played the fanfare's first note, a low C, at full
    volume, after the held high C. The sound module now sees the pause end
    on that update (paused & ~level_done), and goes quiet.
    level_cleared now also listens: C, E, G and a held high C in the pause,
    and quiet when the new wall comes in. Against the old RTL it fails on
    both (a fifth note, and the new wall in with a note of 30 lines at
    volume 7).
    [tt_um_tiny_breakout.sv]
2026-11-09 Sound the paddle and the walls only when the ball bounces off them
    At 1x and 1.5x the ball moves only on some frames, so in the frame
    after a bounce it can still touch the paddle or the wall it is already
    leaving, and the contact counted again: the thock and the thump, or the
    rumble, started over a frame later. The sound now takes the paddle only
    while the ball is falling and a wall only while the ball is heading
    into it. The ball's direction and autoplay are unchanged.
    The sound scenario now counts the paddle bounces in the picture and
    wants one thock each, and a rumble that fades rather than starts again.
    Against the old RTL it fails on both (4 thocks for 2 bounces, and a
    rumble that rest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
    [tt_um_tiny_breakout.sv]
2026-11-09 Drop the sound's unused frame_phase port and bring its comments up to date
    sound.sv never used frame_phase; it was only in _unused, with a note
    that explained nothing. The port and its connection go, and the unit
    test stops driving it. The comments said nothing interrupts a lost
    ball or game over on voice A, but a new game does; the top level's pin
    list and section list left out the audio pin and the sound; its LFSR
    comment left out the sound's noise; and the celebration's comment said
    the pause is 17..31, where the pause is 16..31 and the bands show from
    17. No change to the logic.
    [sound.sv, test_sound.py, tt_um_tiny_breakout.sv]
2026-11-09 Correct the test README's scenario count, simulators and gate-level steps
    It said there were 12 gameplay scenarios judged from the video alone; there are now 14, and
    the sound scenario also judges the audio pin. It said the system tests and the player always
    use .tools/v4; they prefer it and fall back to the Verilator on PATH, which the macOS setup
    relies on. It said the pytest suites build their own sources; the system tests read
    info.yaml's list, and only the unit tests name their own. The gate-level command lacked the
    PATH the RTL command sets, and didn't say that PDK_ROOT must be the directory holding
    sky130A, which under ciel is a version directory rather than ~/.ciel.
2026-11-09 Fix the wall's seed row, pinout pointer and Audio Pmod in the docs
    The README said a new wall's first row comes from the LFSR; the seed is the bottom row, row
    5, which is the first one built. It said the pinout is in docs/info.md, which has the
    controls and the pin ranges each Pmod uses; it now points to info.yaml for the per-bit map.
    docs/info.md's "How to test" now says the Audio Pmod on uio[7] is optional, for sound.
    info.yaml's comment on the source list now names CI's lint step among its readers.
2026-11-09 Date the flow settings' area figures and add the sound to the LFSR's readers
    The comments on SYNTH_EXCLUDED_CELL_FILE, EXTRA_EXCLUDED_CELLS and the clock buffers in
    config.json, and the header of synth_excluded.cells, quoted utilisation and area figures
    (80.5% -> 61%, 51 buffers and ~290 um2, 32 clkbuf_16 leaves and 1,076 -> ~400 um2) without
    saying they were measured before the sound was added. Next to the comment giving ~81% with
    the sound, they read as current; each now says when it was measured. The settings are
    unchanged.
    lfsr.sv's header named autoplay and the wall as its readers; it now also says the sound
    mixes the low four bits into its noise, a new value every frame.
    [lfsr.sv]
2026-11-09 Test the sound's PWM at the audio output
    No test looked at voice A at the audio pin, or at the PWM duty of either
    voice: the interleaving test sounds only voice B and checks only that its
    clocks are sometimes high.
    The new test sounds a brick (voice A, volumes 5 down to 1) and a wall
    rumble (voice B, 3 down to 0) together, with the noise held at 1, and
    over one PWM period per line checks every output bit: on voice A's clocks
    it is high for exactly the first a_vol of the 8 steps while a_square is 1
    and low while it is 0 (both halves of the square wave are seen at each
    volume); on voice B's clocks it is high for exactly the first b_vol.
    It fails on three mutations of src/sound.sv: `pwm <= a_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
    [test_sound.py]
2026-11-09 Measure the tone's pitch on a note other than the default
    The pitch test played a red brick, N = 30, which is also a_note when no
    sound plays, so a tone counter that ignored a_note and reloaded 30 would
    have passed it. It now plays row 5 with the ball fast (scale step 2, E5,
    an octave down N = 48) and counts the square wave's flips over 480
    lines: 10, give or take one.
    With the counter reloading a constant 7'd30 instead of a_note in
    src/sound.sv it fails with "15 flips in 480 lines (expected 10 for
    N = 48)". It passes under Verilator and Icarus.
    [test_sound.py]
2026-11-09 Measure the pitch of the new-game chord's upper voice
    Voice B's tone counter (b_count, b_square) was never measured: the chord
    test checks only b_note, the note it should load. The new test starts a
    new game and counts b_square's flips: 20 (give or take one) in 400 lines
    for G5, N = 20, over the first 8 frames, then 30 in 360 lines for E6,
    N = 12.
    It fails with the counter in src/sound.sv reloading a constant instead
    of b_note: with 5'd20, "E6: 17 flips in 360 lines (expected 30 for
    N = 12)"; with 5'd12, "G5: 33 flips in 400 lines (expected 20 for
    N = 20)". It passes under Verilator and Icarus.
    [test_sound.py]
2026-11-09 Check the sound pins in the full-chip test
    test.py never looked at uio_oe or uio_out, so nothing that runs on the
    gate-level netlist checked that the audio pin is an output or that it
    makes any sound.
    The new test checks, on every clock it samples, that uio_oe is 0x80 and
    uio_out[6:0] is 0, and that the chip is silent for a line after reset.
    It then holds the direct LEFT button through the first frame update,
    which ends the demo at the second and starts a new game, and samples 40
    lines from the end of that frame's vsync pulse: the new game's chord
    (both voices at volume 6, square waves of 60 and 40 lines) must make
    uio_out[7] high on between a quarter and a half of the clocks (9/32 to
    15/32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
    [test.py]
2026-11-09 Add a tool that records the demo as a movie with its sound
    tools/movie.sh simulates the design from reset with no controller
    connected, using the player's model (sim/play/sim.h), until 3 seconds
    into the second level, found from the picture (the wall empties, then
    fills again). tools/movie.cpp streams each frame to ffmpeg as RGB and
    the Audio Pmod's sound to a file; the script then adds the sound,
    normalised to a peak of -1 dB. The result is H.264 and AAC, 640x480 at
    60 fps: today's demo is 190 s in 1.2 MB, taking about 11 minutes here.
2026-11-09 Repair hold to a 0.05 ns margin after placement instead of 0.1
    With the sound's latest fixes the design got stuck in detailed routing
    at about 4,300 violations, and placing it with two other register
    orderings didn't help. Most of the delay cells hold repair added were
    there only to reach the template's 0.1 ns margin above zero slack: 135
    of them, against 46 at 0.05 ns. Without the other 89, the final cell
    utilisation fell from about 85% to 78.9% and met2's track usage from
    58% to 50%, and the design routed clean: 0 DRC, LVS and antenna errors,
    setup slack +26.1 ns, hold slack +0.028 ns at the worst corner (on top
    of sign-off's 0.25 ns clock uncertainty and 5% derate), no new kinds of
    warnin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
2026-11-09 Never build the full wall after level 1
    Each later wall grows from a 4-brick seed row taken from the LFSR, and
    from the seed 1111 every row grows full, so the wall repeated the first
    one. Three of the 31 LFSR values gave it (15, 30 and 31), and the demo,
    which plays the same game every time from reset, reached one of them at
    level 2, so it never showed a second kind of wall.
    The seed now drops its last brick when the other three are set. Value
    15 now gives value 14's wall, and 30 and 31 a new 32-brick pattern, so
    there are still 21 different walls, of 20 to 32 bricks instead of 20
    to 48 (tools/walls.sh). A new rule test, which any layout must keep,
    checks that no wall is full; it fails on t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
    [test_wall_pattern.py, wall_pattern.sv]
2026-11-09 Keep the bricks hidden until the wall is built
    A new wall is shifted into the ring with the row turns of the frame
    after a refill, and the bricks stayed hidden until the last row turn
    (line 144). The beam then drew the bottom row from the half-built ring,
    so for one frame after reset, each new game and each new level, only
    the bottom row flashed up. They now stay hidden until the end of the
    wall (line 160): that frame shows no bricks.
    The brick-wall test now expects no bricks while the wall fills, and
    fails on the old RTL. level_cleared watched for autoplay holding the
    paddle while the wall was empty, which now takes in the filling frame,
    when play has resumed: it now checks only while the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
    [brick_wall.sv, test_brick_wall.py]
2026-11-09 Bring the README's layout picture and figures up to date
    The picture showed the tile from before the sound; it is now Tiny
    Tapeout's GDS render from CI's build of 45d34e3, scaled to 800 px with
    a 256-colour palette as before. From that build's netlist: 14,582
    transistors in 1,634 standard cells (fill, tap, decap, diode and tie
    cells not counted), with 197 flip-flops. Most of the drop from 15,204
    in 1,722 is the hold-delay cells the 0.05 ns hold margin removed.
2026-11-09 Name the part and frame of each failed scenario check
    A failed check now says which part of its scenario it comes from and
    the frame since power-up, ahead of the message, and the scenarios
    power up through power_up, which restarts the frame count. Each
    scenario's part is its name for now; merged scenarios will set their
    own as they go, as their separate names no longer tell their checks
    apart. Past 100 failures the rest are only counted, so a broken
    per-frame check cannot flood the output.
2026-11-09 Merge the hand-played control checks into one scenario
    One new game, played by hand from the pins, carries what launch,
    steering, paddle_limits and select_turns_autoplay_on check, and the
    new-game chords and the quiet while the ball waits from sound, part by
    part. It also checks the colours of one frame: each row of bricks, the
    walls, the field and the paddle.
    Steering now measures each 10-frame press a frame after its release:
    a frame shows the paddle as the frame before left it, so the last move
    of a press showed only if the press began on the right frame. As the
    scenario reaches steering after the chords, not 6 frames after reset,
    a left press read 12 px. Measured this way, a press moves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
2026-11-09 Merge the losing scenarios into one, losing_every_ball
    falling_ball_lights_the_border, game_over_curtain and
    game_over_and_restart each played the same game to its end, the paddle
    parked at the left wall and FIRE whenever the ball rested, and sound
    lost every ball once more after its autoplay. One game now carries all
    their checks, part by part:
    - losses: the border's shade every frame as each ball falls, the
    markers counting down, each new ball at 1x, and the sighs and the
    trombone as the balls go
    - game over: no ball and no markers, the score at 10 per brick
    - curtain: 32 lines on its first frame and 16 more each frame, the
    border black and no ball meanwhile, then only the score lef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
2026-11-09 Shorten the demo scenario and check unplugging and a controller's fire
    The demo scenario, now named demo, still ends the demo in its three
    ways, but no longer plays 900 frames of it each time. The run without a
    PMOD plays until the demo clears a brick (at most 900 frames); the
    other two only check that the demo launches the ball, which is what
    their way of ending it needs. After each new game the 60 frames without
    input are kept: they caught autoplay lingering after the demo.
    The run that ends the demo by connecting a controller goes on: A
    launches the new game's ball, and unplugging the controller resumes the
    demo in that game. The ball flies on rather than going back onto the
    paddle, the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
2026-11-09 Add the opening and the long game, each check following play as it goes
    The long game, the milestone tier's one scenario, plays a game from a
    new game to the third wall and back to a new game, simulating each
    expensive stretch once:
    - level 1: autoplay clears the wall (at frame 10,682) without losing a
    ball, which is now checked rather than printed; the score is right
    at every brick, the ball takes all five speed steps, and every zone
    is seen, 16 bounces in all. That is the game that brick_bounces,
    ball_speeds_up, paddle_zones_set_the_angle and
    autoplay_clears_a_level each played.
    - the pause, as level_cleared checks it: the paddle held, the rainbow,
    its length, the fanfare and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
2026-11-09 Check every frame for the ball in a wall and for a wall coming in whole
    Every frame of every scenario is now checked for two things:
    - The ball never gets into the outer half of a wall. A ball touching a
    wall turns at the next frame update, by then at most two moves (4 px)
    into it, so nothing white may show in the outer 4 px of the side
    walls or the top wall. Until now the walls' bounces were only implied.
    - A new wall comes in whole: when the brick count rises, the frame
    before showed no bricks. The frame in which a wall fills shows none;
    with the RTL before 45d34e3 it showed the bottom row, which only the
    brick_wall unit test caught. Now every scenario fails on it, from the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
2026-11-09 Play the new game's call over a bass, without voice B's tone counter
    Voice B played notes of its own only in the new game's two chords; all
    its other sounds are noise. The new game now plays a call on voice A,
    G4, D5, G5 for 4 frames each and then C6 for 20, and voice B plays it
    an octave below: a flip-flop that flips at every other flip of voice
    A's square wave. That replaces voice B's counter, square wave and note
    table, which frees 1.49 points of Tiny Tapeout's placement utilisation
    (81.31 % to 79.82 %, the mean of three register orderings; a no-op
    change measured the same as the baseline).
    Everything else sounds the same: from reset through the demo the audio
    is bit-identical, and later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
    [sound.sv, test.py, test_sound.py]
2026-11-09 Read autoplay's aim off the beam: sample the paddle zone under the ball's columns
    The drawing already works out the paddle zone for every pixel. Sampling
    it as the beam crosses the ball's columns (ball x, x + 3, x + 7) on
    every line replaces autoplay's adder and two 8-bit compares with two
    2-bit compares and two flip-flops. Each step is still decided on the
    positions the step before left. The paddle now stops once the deciding
    pixel is 2 px inside the target zone rather than near its middle; the
    bounces, and so the game, are the same whenever the paddle gets there
    in time: the demo clears its walls on the same frames as before.
    This frees 1.99 points of Tiny Tapeout's placement utilisation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
    [autoplay.sv, test_autoplay.py, tt_um_tiny_breakout.sv]
2026-11-09 Recognise sounds in the tests by what makes them that sound
    Some checks told sounds apart by properties that only happened to be
    unique, so a change to an unrelated sound broke them:
    - A lost ball's sound was the first note at full volume, 25 or 40
    lines, and the new game's call also starts on 40. Sounds are now
    named by their first two notes (sigh, trombone), and the call by its
    bass.
    - A rumble was voice B with runs of multiples of 8 lines, as a low bass
    note's are too. A rumble is now noise (runs of differing lengths, a
    tone's are all its half-period) whose runs are multiples of 8.
    - The full-chip test expected the share of high clocks of one tune.
    It now checks what holds for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
    [test.py]
2026-11-09 Put a lost ball's successor on the paddle before launching it
    After a lost ball the next one goes onto the paddle at the next move,
    and speed_level is back at 0, where odd frames have no move. With FIRE
    held, as autoplay and the demo always hold it, serving dropped at the
    frame update regardless, so on an odd frame the ball flew on from below
    the screen and was lost again, and again, down to game over. That could
    happen to any ball lost faster than 1x. Serving now stays on while the
    ball is still lost, delaying the launch by at most a frame.
    A new cheap scenario, lost_at_speed, lets autoplay speed each ball up
    to 1.5x, then loses it with the paddle held at the left wall and FIRE
    held, and c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
2026-11-09 Correct comments the review found wrong or unclear
    - gamepad_rx: the buttons need no reset not because a whole report sets
    connected (it is set at the DOWN bit, before them), but because for
    the few microseconds until they follow, stale LEFT and RIGHT cancel
    and the connection's new game takes priority over FIRE. Its _unused
    takes the same form as the other modules'.
    - The top: frame_tick is where a frame's moves begin, if any; hit_zone
    points at paddle_zone and says when the deciding pixel differs; the
    demo is allowed since reset; the rainbow band's formula, spelt out.
    - score: the digit's position in its cell and on screen, kept apart.
    - config.json: the 81 % utilisation that c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
    [gamepad_rx.sv, score.sv, tt_um_tiny_breakout.sv]
2026-11-09 Tune the sounds to one style: brick notes in tune, the fanfare over the bass, the call at 8 frames a note
    - Bricks played the pentatonic scale an octave down by doubling a table
    of half-periods, and the table's D6 (13 lines) doubled to 26: 605 Hz,
    52 cents sharp of D5. The table now holds the bricks' own octave, with
    D5 at 27 lines (14 cents flat), like the other notes within 15 cents.
    - The new game's call, both voices at volume 6, was louder than the
    cleared-wall fanfare on one voice at 7, and the only tune with the
    bass. Voice B now plays the octave below under the fanfare too: the
    fanfare is the loudest sound (1.6 dB above the call, from 1.4 below).
    - The call moved in 4-fram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
2026-11-09 Correct the sound module's comments, and call the wall sound a rumble
    - Not only a new game replaces a lost ball's sigh or the trombone: the
    pause and another loss do too; it is a brick or the paddle that
    doesn't.
    - The paddle and wall inputs are bounces, as the top passes them, not
    any touch.
    - The note that N < 64 no longer applies: the brick table isn't doubled.
    - "Thump" named both the paddle's noise and the wall sound; the wall
    sound is the rumble, as in the code, here and in the datasheet.
    [sound.sv]
2026-11-09 Define fire in info.md, say which gamepad buttons do nothing and which controller is read, and that the direct inputs need pull-downs
2026-11-09 Recognise sounds and game states in the scenarios by what defines them, and close review gaps
    Sturdier recognition:
    - The lost-ball sigh and the trombone are found as runs of notes in voice
    A's sequence (E-flat D C, G4 F#4 F4), not by the full volume they
    start at.
    - The thock is known by its falling notes (60, 66, 72 lines, a brick's
    C4 holds its note), the thump and rumble as noise stepped every line
    or every 8 lines; their volumes are checked to fall, not matched.
    - long_game knows game over by its curtain, not by the ball staying gone
    for three frames.
    - The paddle is read on its bottom line, 455, which a bouncing ball
    can't cover (it could at 450, silently skipping zone chec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
2026-11-09 Check the tones' pitch to the line: every whole half-period, not a count of flips that a neighbouring note also gives
    [test_sound.py]
2026-11-09 Test the trombone to its end, and that only a new game cuts voice A's sigh or trombone short
    [test_sound.py]
2026-11-09 Test voice B's endings: the thump's and rumble's fades, and the bass when voice A's call is replaced
    [test_sound.py]
2026-11-09 Spell out the trombone's wobble in the sound module's header: 48, 49, 50, 49 lines
    [sound.sv]
2026-11-09 Start a new game after game over only once the curtain is down
    FIRE started a new game on the first frame after game over, so a player
    holding it as the last ball fell (or autoplay, which always holds it)
    skipped the curtain and cut the trombone after one frame. A restart now
    also needs speed_level at 31, where the curtain is down, about half a
    second after the last ball: the same compare that ends the pause after a
    cleared wall, so it costs a gate.
    losing_every_ball holds FIRE through most of the curtain's descent and
    checks that no new game starts; the datasheet says when fire restarts.
    [tt_um_tiny_breakout.sv]
2026-11-09 Start a player's first game after reset with the call, like every other new game
    The call plays when a new game starts: on fire after game over, or when
    a controller connects or a direct button is pressed while the demo runs,
    ending it. A controller already recognised at the first frame update
    after reset never ended a demo, so that first game started silently.
    demo_was now resets to 1, as if the demo had been running, so that
    controller ends it at once and the game starts with the call. Without a
    controller nothing changes: the demo starts silently.
    [tt_um_tiny_breakout.sv]
2026-11-09 Find the sky130 library without failing the caller, and prefer LibreLane's PDK version
    Under the callers' set -euo pipefail a failing find (no $PDK_ROOT, say) made
    local_area.sh, equiv.sh and lec.sh exit silently, and flow.sh harden report a blank LEC
    line; now they reach their own 'not found' message. With several PDK versions installed,
    the choice no longer depends on find's order.
2026-11-09 Run every tool's Python with the project's .venv, from one PY in common.sh
    Some scripts used the system python3, walls.sh the .venv's, and flow.sh whatever python
    was first after activating it; tools/README says they use the .venv.
2026-11-09 Give flow_avg.sh's orderings SRC_DIR's own synth_excluded.cells, as flow.sh would
    It copied only the .sv files, so flow.sh fell back to src's cell list.
2026-11-09 Take flow.sh's VERILOG_FILES from info.yaml's sources, not user_config.json's copy
    src/user_config.json is made once from info.yaml, so its list went stale when a module
    was added or removed. EXTRA_CFG still has the last word.
2026-11-09 Check flow.sh's TAG and flow_avg.sh's NAME before building paths to remove from them
    Both rm -rf directories named after them, so a name like ../x reached outside runs/ and
    build/. Now only letters, digits, _ . and -, not starting with a dot; else the usage.
    Extra arguments also give the usage.
2026-11-09 Report lec.sh failures in full: the FSM note, and every line indented in flow.sh
    In lec.sh, under pipefail a grep with nothing to show ended the script before its note on
    recoded state machines; that note's check is now a plain grep -q, and its sed uses
    [^[:space:]] rather than GNU's \S. flow.sh's two LEC branches were the same and indented
    only a failure's first line: one echo through sed, as for the warnings.
2026-11-09 Check movie.sh's and walls.sh's options, and movie.sh's Verilator version
    A missing option value, a --extra that isn't a whole number of seconds, an unknown option
    or an extra argument now give the usage, not an unbound-variable or arithmetic error.
    movie.sh stops with a message unless it finds Verilator 4, instead of failing in C++.
    For macOS: abspath in common.sh replaces realpath -m, which BSD's realpath lacks, and
    flow.sh's empty TO array expands safely under set -u on bash 3.2. walls.sh makes the
    directory for --png.
2026-11-09 tools/README: movie.sh needs Verilator 4, flow.sh's .exp_src_TAG/, walls.png in build/
    The table and setup notes said only ffmpeg for movie.sh. flow.sh's source copy in the
    repo root is git-ignored like build/ and runs/. The wall-layout recipe wrote its PNG into
    the repo root.
2026-11-09 Check the player server's port argument and socket, and report bind and listen failures apart
    [serve.cpp]
2026-11-09 Give a replaced player tab its takeover header even when its buffer is full
    The header was sent without waiting, so a stalled tab could miss it, reconnect and take the
    stream back; and a stream replaced before it started was closed without one. Both now get it
    with a short wait, outside the lock.
    [serve.cpp]
2026-11-09 Answer each player request on its own thread, so idle connections don't hold up keys
    Browsers and port forwarders open speculative connections that send nothing; the single
    accept loop waited up to 200 ms on each before reading the next request.
2026-11-09 Leave browser shortcuts, held keys and focused controls alone in the player
    A, R and M acted on every key repeat and with Ctrl, Cmd or Alt (Ctrl+R sent a reset before
    reloading), and the arrows and Space were taken even from a focused volume slider or mute
    button. Controls used with the mouse hand the keys back to the game, as before.
2026-11-09 Start the player's sound one press at a time, and say so in the status line if it fails
    A second press while the worklet loaded flipped the state with no node yet, and a failed load
    left the button unmuted and silent for good. Presses during a change are now ignored, a failed
    start keeps nothing (so the next press tries afresh), and muting drops the buffered samples so
    that an unmute doesn't play them.
2026-11-09 Name the pins and colours in the full-chip test, and decode a pixel's whole colour
    The pin bits of uo_out, ui_in and uio get names instead of 0x8F, 0x7F
    and bare bit numbers, and colour() reads a pixel as 6 bits {r, g, b}
    as colour_pkg has them, so the paddle is found by its full colour
    rather than 4 of its 6 bits. tb.v names the two sync pins, for edge
    triggers and the waveform view.
2026-11-09 Check the gamepad's paddle step by step, by its width and with the ball on it
    The test told the gamepad from the demo only by the paddle's direction.
    It now asserts one 4-px step in two frames at the base speed, a paddle
    96 px wide in its full colour, and the ball resting on its middle (the
    demo would launch it).
    The pixels are read with a wait from the vsync edge to each one, half a
    clock into it, instead of counting hsync pulses with a Python step per
    clock: the test takes about 120 s rather than 165.
2026-11-09 Test the picture: the vsync pulse, and pixels of each kind on the demo's screen
    test_picture times vsync's 2-line pulse and 525-line period by its
    edges, and between them reads 14 pixels of the demo's second frame,
    the first with the bricks, each from one wait after the vsync edge: the
    score's top stroke and its inside, both spare balls, the black status
    line and borders, the walls, a red brick in row 0 and a violet one in
    row 5, the field and the paddle. Each is at least 2 px from any other
    colour on its line, so a clock's offset can't change it.
    test_vga_timing times hsync by its edges too, and times are kept in
    whole ps, which Timer takes exactly.
2026-11-09 Explain the sound test's bounds, and wait for the vsync pulse's end by its edge
    The docstring now says why the audio pin must be high on more than 1/16
    of the clocks (one voice from volume 3 up, the call giving 3/8) and
    change more than 1000 times (the modulation's pulses, some 8000 at the
    least, against about 10 flips for a bare note), beside the 7/8 upper
    bound. The wait for the end of vsync takes one edge trigger instead of
    a Python step per clock, and the long wait is written in lines.
    [test.py]
2026-11-09 Check in the full-chip test that a game the controller starts before the first frame update has the call
2026-11-09 Move the paddle at 1x in the pause after a cleared wall
    The paddle moves with the ball, so it speeds up with it: deliberate, as
    it keeps every catch within reach at every speed. But in the pause
    after a cleared wall speed_level is the pause's timer (16..31), so the
    paddle, with the ball resting on it, raced at 3x for no reason. It now
    moves at 1x there, as the next ball will. paused holds through the move
    lines (the wall's emptiness is read off the picture above them), so the
    move count can use it; its wires move below paused's.
    long_game steers the paddle by hand away from the nearer wall in the
    pause and checks it moves at 1x: 4 px, never in two frames running.
    The datasheet notes the exc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
2026-11-09 Register the direct input pins once, so every flip-flop sees one value per clock
    ui_in[0..3] (LEFT, RIGHT, FIRE, autoplay) fed many flip-flops through logic of
    different lengths, so a pin changing just before a clock edge could reach some of
    them and not others: a restart could reset the lives but not refill the wall, or the
    paddle's 8 bits could mix its position and the next and put it anywhere, even past
    its stops. They now go through a 4-bit register, direct_q, and the game reads only
    that. One stage is enough: the danger is that disagreement, not metastability, and a
    register that does go metastable has the slack of the paths from it (the design's
    worst setup slack is about 25 ns of 40)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
    [tt_um_tiny_breakout.sv]
2026-11-09 Say where test checks restate the RTL's own rule: they catch a broken implementation, not a wrong rule
    [test_autoplay.py]
2026-11-09 Declare the top module's two struct-typed definitions as the style note says, and note its exceptions
    ui and lost_rgb were `logic` with an `assign`, while the style note asks
    for `wire x = expr;`. Typed nets work in every tool the project uses
    (yosys 0.62, Verilator 4 and 5, Icarus 12 and 13, checked), so they are
    now `wire T x = expr;`. The note names the two exceptions kept on
    purpose: signals used before their logic, declared ahead and assigned
    there, and tiny_vga_out's pins, filled in field by field. Formally
    equivalent to before, and the same area.
2026-11-09 Bring the README's layout picture and transistor count up to date
    The picture is Tiny Tapeout's render (tt-support-tools' render_png, with
    sky130's settings for a 1x1 tile, as CI renders it) of a local harden of
    8aec637, at the same 1610 x 1116 as before; re-rendering CI's GDS of
    45d34e3 the same way matched CI's picture but for the palette pngquant
    chose. From that run's netlist: 14,410 transistors in 1,591 standard
    cells (fill, tap, decap, diode and tie cells not counted), with 198
    flip-flops: "some 14,400 transistors in 1,600 standard cells" and
    "about 200 flip-flops".
2026-11-09 Keep the project to plain ASCII
    - The SPDX headers drop the copyright sign: "SPDX-FileCopyrightText:
    2026 Alexei Zverovitch" says the same.
    - The datasheet's 640x480 and 8x6, and the tools README's um2 (as
    local_area.sh prints areas).
    - The player's page: Left/Right for the arrow keys in its help line,
    "..." for the ellipsis, "-" for the dashes and "|" between the status
    line's items.
2026-11-09 README: describe the ball's three-bit velocity and fixed step instead of how a faster ball moves
2026-11-09 Date the measurement behind the comment on two's-complement velocities
2026-11-09 Drop the figure from the comment on two's-complement velocities: d520be9's message records the measurement
2026-11-09 Fix three long-game checks that misread the picture
    - The fanfare's bass is checked from the pause's second frame: the first
    can still play the last brick's note, which can vanish from the
    picture a frame before its sound.
    - The speed check counts a new ball from a spare-ball marker used or a
    new wall, not from a ball seen resting: with the paddle now read on
    its bottom line, a ball bouncing through y 440 over its middle looked
    like one served.
    - The brick bounce and note checks skip a hit when another brick
    vanished a frame before or after: two bricks hit in one frame (both
    bounces count, and the note is the second's) can show a frame apart.
    The long game passes again (78 bou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
2026-11-10 Build the FPGA bitstream on every push, timed against the board's 25.175 MHz
    Tiny Tapeout's template ships the FPGA workflow switched off. It now
    runs on every push, and places and routes against the 25.175 MHz the
    board supplies for 640x480 at 60 Hz rather than tt_fpga.py's 12 MHz
    default: the tool doesn't allow a timing failure, so a change that
    slows the design below the board's clock fails the build. The seed is
    fixed (the tool's default, 10) so a bitstream rebuilds the same.
    Built locally the same way (yosys 0.62, nextpnr-ice40, UP5K): 842 of
    5,280 logic cells, and 25.40 MHz at seed 10 (25.4-26.7 over six seeds),
    limited by the per-pixel collision path.
2026-11-10 Register vblank_start, decoded a clock early
    vblank_start (the game's frame_tick) starts the frame update, the widest logic in the
    design, and came from a comparator on the beam counters. It is now a flip-flop loaded at
    the last clock of the last visible line, so the frame update's paths start at a register.
    The iCE40 FPGA build needs the time: with the collision registers that follow, the board's
    25.175 MHz is met with margin.
    The pulse is unchanged: Icarus compared the old and new modules on every clock for two
    frames after reset, which covers every state the counters reach (vblank_start depends on
    them alone). tools/equiv.sh can't prove it, as its induction also considers counter values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
    [vga_timing.sv]
2026-11-10 Register the collision results before the flags, the score and speed_level
    Finding a touch takes the ball's whole pixel test and the brick or paddle under the beam,
    and the edge test, the hit flags, the score's carry chain and speed_level's incrementer
    added onto it within the clock: the slowest paths in the iCE40 FPGA build. Five flip-flops
    now hold the touch (clear_brick_q, side_hit_q, paddle_touch_q and paddle_zone_q, the zone
    under the beam then), and those consumers take it a clock later. Only the brick's own clear
    still acts on the pixel, as the wall's ring turns with the beam.
    A clock late is unseen: the flags are read at frame_tick (line 480; the last touch is on
    line 455), the scor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
    [tt_um_tiny_breakout.sv]
2026-11-10 System tests: stop lost_at_speed at its first failed round, and cap the cheap waits by need
    lost_at_speed recorded a failure and played on, up to 8 rounds of a 3000-frame wait for
    autoplay to clear 4 bricks and a 3000-frame wait for the ball to be lost. Its rounds now end
    at the first failure: with lost balls costing nothing, it fails after round 0 in 173 s, where
    main's version plays all 8 rounds.
    The waits are sized from what main's design takes, measured with the waits instrumented and
    lost_at_speed's rounds sampled from 9 LFSR states (39 rounds):
    - lost_at_speed, 4 bricks at 1x: 1450-2000, up to 2925, and once more than 3000, so 3000
    could fail a working design: now 8000. Ball lost at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
2026-11-10 Docs: correct the bounce sentence, update the cell count, and tidy two passages
    - README: a paddle bounce sets all three velocity bits, so "sets or flips one of them" was
    wrong; "brick walls" as elsewhere; the noise is for the paddle and wall sounds (the docs
    don't name a thump); the badges get alt text. From the harden of 916a405, counted as in
    139661e: 14,177 transistors in 1,549 cells.
    - info.md: the red margin comes before game over, as it applies to every lost ball, and the
    paragraph is rewrapped; unplugging and replugging the controller also restarts a game.
2026-11-10 Comments: who reads the registered collision results, and other review fixes
    From the review of 916a405 and the code around it; the hardware is unchanged
    (tools/equiv.sh: 855 of 855 cells proven).
    - The sound's brick note also reads hit_row and speed_level, only at a line start, so a
    clock late is harmless there too; sound.sv's port note says they may change mid-frame.
    - The no-reset argument holds from reset's second clock; the score's reason is above.
    - The ball resting on the paddle never touches it by geometry; the serving mask is the guard.
    - paused drops in the frame that ends the pause, with the same move count.
    - The style note's exceptions include output ports; the 25 ns slack is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
    [sound.sv, tt_um_tiny_breakout.sv]
2026-11-10 fpga workflow: say truly what the fixed seed does
    10 is already tt_fpga.py's default, and a rebuild isn't the same bitstream
    anyway: the action installs a nightly oss-cad-suite and tt-support-tools
    from main.
2026-11-10 System tests: say the call's notes last 8 frames each, then 24, as the check and sound.sv do
2026-11-10 System tests: print each lost_at_speed round as it ends, and its true frames to the next ball
    A timeout showed nothing, as the scenario printed only at its end. The delay
    from a loss to the next ball resting was counted from 1, one more than the
    frames it took, while the check's message said the true count.
2026-11-10 System tests: after lost_at_speed's last ball, wait for the new game's wall
    The loss ended on the new game's first frame, which shows its markers but
    not yet its wall, so the next round began counting cleared bricks from 0
    and was saved only by resetting its count once the ball rested.
2026-11-10 System tests: lose lost_at_speed's last ball at 1x, without speeding it up first
    The last ball's loss ends the game and is not checked, so autoplay's 4
    bricks before it only cost time. Losing it straight from the paddle
    saves about 460 of 9,600 frames on the current design (24 s of 8 min):
    less than hoped, as the paddle sends that ball up again before it falls.
    The loss's frame cap rises from 2000 to 3600 to cover a ball at 1x.
2026-11-10 System tests: give the cheap tier 30 minutes, as a passing lost_at_speed can take 20
    It can play all 8 rounds and pass, about 14,000 frames, or up to 20,000
    if autoplay is slow to clear its bricks: up to 20 minutes on a busy
    machine, so the old 20-minute limit was not only a hang.
2026-11-10 RTL: logical operators on 1-bit flags and conditions, bitwise on vectors
    Adopt one operator convention across src/*.sv and state it in the top
    module's style note: logical (&&, ||, !) on 1-bit flags and conditions,
    bitwise (&, |, ^, ~) on vectors and for bit-level work such as masks and
    XOR. Converts the 1-bit & / | / ~ uses to their logical forms. The moves
    comment loses its note about a cast widening a & b, which no longer
    applies. No hardware change: tools/equiv.sh 69aafdc proves equivalence.
    [autoplay.sv, brick_wall.sv, gamepad_rx.sv, sound.sv, tt_um_tiny_breakout.sv, vga_timing.sv]
2026-11-10 Tang Nano 20K: the game with HDMI picture and sound, built with open-source tools
    The game is tt_um_tiny_breakout, unchanged, playing its demo. breakout_hdmi joins it to
    hdl-util/hdmi: both frame counters reset on the same clock and stay equal, the game's
    registered colour lines up with what hdl-util takes, and the audio pin's 16-clock PWM blocks
    give the mix, sampled at 48 kHz (525 clocks at 25.2 MHz). tn20k_top makes the clocks (27 MHz
    to 126 and 25.2 MHz) and drives the HDMI pins.
    tools/build.sh runs yosys (yosys-slang for the SystemVerilog), nextpnr and gowin_pack from
    this board's own .venv, and applies a 2-line patch to a copy of hdl-util that yosys-slang
    needs. Timing: about 155 MHz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
    [breakout_hdmi.sv, tn20k_top.v]
2026-11-10 Tang Nano 20K: simulation test of the picture's alignment and the sound's blocks
    Verilator runs breakout_hdmi for 400 frames of the demo (the first sound is in frame 283)
    and checks that hdl-util's frame counter equals the game's on every clock, that the pixels
    it sends are the game's visible pixels in order, and that each 16-clock audio block holds two
    volumes, whose sum is the level sent.
2026-11-10 Tang Nano 20K: CI workflow, fpga_tang_nano_20k
    Two jobs: the bitstream (the board's own .venv, then tools/build.sh, uploaded as an artifact)
    and the simulation test (Ubuntu's Verilator, as the lint job uses).
2026-11-10 Tang Nano 20K: a DVI_ONLY parameter, which the test sets instead of a defparam
    Ubuntu's Verilator 5.020 (CI's) rejects a defparam more than one level down, so the test's
    reach into hdl-util for its DVI_OUTPUT failed there. breakout_hdmi now passes DVI_ONLY on to
    it: the test sets it, and it builds a picture-only version for DVI-only monitors. Off by
    default, so the bitstream's design is unchanged (same timing and size).
    [breakout_hdmi.sv, tb_breakout_hdmi.sv]
2026-11-10 Tang Nano 20K sound: the player's filter (sim.h) in hardware
    The HDMI samples were the last 16-clock block's level, taken every 525
    clocks with no filtering, and positive only. That put a note's edges up
    to a sample late in a pattern repeating every 21 lines (sidebands around
    each harmonic), let the noise alias, and sent DC. On a board the paddle
    sounded flat.
    breakout_hdmi now computes what sim/play/sim.h does for the player: a
    3rd-order CIC filter decimating by 525, then a 50 Hz high-pass (the
    Pmod's AC coupling), so the board sounds like the player. The 16-clock
    blocks, and their exception at line 480, are gone. The test runs sim.h's
    code on the audio pin and checks the samples against i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
    [breakout_hdmi.sv, tb_breakout_hdmi.sv]
2026-11-10 README: the SKY26e shuttle, and the FPGA boards with links to their READMEs
2026-11-10 README: the FPGA links go straight to the boards' READMEs
2026-11-11 Level clear: the field twinkles, then each wall builds a row at a time
    The rainbow bands in the pause after a cleared wall become a twinkle:
    crosses in 16-px cells of the field, coloured by height like the brick
    rows, each cell lit for 4 frames once in the pause (a 5-bit hash of the
    cell gives half the cells one of the timer's 16 steps). Then every new
    wall, a game's first too, is built a row at a time from the bottom, each
    row landing white, over about a second while the ball waits on the
    paddle; speed_level is the build's timer, and one flip-flop marks it.
    Hardened (b16_build): 81.1% TT utilisation, 0 DRC, LVS and antenna
    errors, setup slack +25.7 ns, hold +0.068 ns, LEC equivalent. One n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
    [test.py, tt_um_tiny_breakout.sv]
2026-11-11 System tests: the milestone tier for the twinkle and the wall build
    The milestone tier's checks still assumed the old timing in places:
    - lost_at_speed's new game after the last ball, and the reset mid-game,
    wait for the wall to be built (wait_for_wall) instead of 6 frames
    - the pause check holds the paddle's centre still, as its left edge moves
    when the paddle narrows for the next level at the end of the pause
    - the twinkle detector ignores white, so the ball just launched after the
    build isn't taken for a twinkle
    - the fanfare's notes are collected from the pause's second frame, as the
    last brick's note can still play in its first (the check of its bass
    already allowed that); the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
2026-11-11 System tests: the brick-note check allows for a note retuned by the next brick
    The sound reads the hit row live while a note plays, so a brick hit in the
    next frame's scan retunes the last brick's note at once, though the
    picture can show that brick gone only a frame later still (cleared after
    the beam drew it). At frame 4703 of the long game a row-4 brick's note was
    heard at row 3's pitch for that reason, a row-3 brick vanishing two frames
    after it. The check now also skips a brick when another vanished two
    frames after it, as it already did for one frame before or after.
    With this the milestone tier passes on main (both scenarios, 23.5 min).
2026-11-11 System tests: the pause's real timings, and test comments brought up to date
    The empty-wall range assumed a fixed pause, but the count depends on the
    frame phase the last brick falls on (69 to 74 frames). The long game sat
    on the old lower bound, so any change to its timing could have failed it.
    [test.py]
2026-11-11 RTL comments: what the twinkle really shows, and what keeps 1x as a pause ends
    The twinkle's comment said every chosen cell lights once in the pause, but
    cells on step 0 never light and step 15 lasts one frame. Comments only.
2026-11-11 warnings.ref: global routing's antenna-repair message, from main's harden
    It is benign (sign-off leaves no antenna violations), so every harden
    shouldn't flag it as new.
2026-11-11 Tang Nano 20K: run the PLL's VCO mid-range, at 1008 MHz instead of 504
    The datasheet gives the GW2A-18's VCO 500 to 1250 MHz, so 504 MHz left
    0.8% margin against losing lock on another chip or a hot day. The output
    doesn't depend on ODIV, so the clocks are unchanged; tried on the board.
    [tn20k_top.v]
2026-11-11 Tang Nano 20K test: colours from the game itself, and a press of the reset button
    The test took its expected colours from the same wire that feeds hdl-util,
    so a swapped channel or reversed level would have passed (it fails now);
    and it never pressed the button, so re-syncing after a reset was untested.
    [tb_breakout_hdmi.sv]
2026-11-11 warnings.sh: fail on an antenna violation left after routing
    LibreLane only reports antenna violations, so with the repair step's
    warning now in warnings.ref, nothing would have stopped a harden whose
    diode didn't clear one.
2026-11-11 brick_wall: keep the five back rows in a tail that turns every clock
    Those 40 bricks only ever moved together, so they needed enable
    flip-flops; turning every clock they don't, and plain ones are a third
    smaller. With the row turns, utilisation falls by about 1.9 points.
    [brick_wall.sv, vga_timing.sv]
2026-11-11 test_brick_wall: resets mid-step, an uneven wall over a phase cycle, refills elsewhere
    The tail's row turns run in five phases, which symmetric pattern walls, a
    run without resets or refills only at line 480 would never tell apart.
    [test_brick_wall.py]
2026-11-12 flow.sh: a repair mode; flow_avg.sh reports utilisation after repair too
    TT's utilisation is taken before the flow adds fanout buffers, the clock
    tree and hold delay cells, about 9 points of the core, so changes that
    save those looked like noise.
2026-11-12 A reference model of the brick wall, proved equal to brick_wall
    brick_wall's turning ring is small but hard to read. ref_wall says the
    same behaviour plainly, and k-induction proofs show that the chip's
    module has exactly its outputs on every clock after reset, and that the
    rest of the chip gives it what that proof assumes. The ring can then be
    changed freely as long as the proofs still pass.
    [brick_wall.sv, ref_wall.sv, wall_contract.sv, wall_equiv.sv]
2026-11-14 physical-design: callouts on the Power step that do not hide the grid
    The VPWR stripe callout carried a sentence about met5, so its box lay
    over a whole pair of stripes (and off the die on narrower screens); the
    panel already says it, for both nets. The VGND stripe and via stack
    callouts pointed at nearly the same spot, and the via stack's dot
    covered the via. Now the stripe labels sit in the gaps either side of
    one pair, the via stack is ringed rather than dotted, and the rail's
    leader slants so it reads as pointing at its dot.
2026-11-14 physical-design: name the single pins one by one on the Pins step
    rst_n, clk and ena shared one bracket, as if they were a bus, and their
    joint label was too wide for it at the default zoom, so the bracket
    stood empty. They are unrelated signals; each now has its name upright
    over its own pin, as every pin does once zoomed in.
2026-11-14 physical-design: show the clock tree's levels in its finished picture
    Every clock net was drawn alike, so once the animation ended the few
    nets near the root were lost among the 235 short leaf nets, and with
    them the trunk the panel describes. Lines now thin out level by level
    from the pin, the upper levels are drawn on top, and hovering a clock
    line names its level.
2026-11-14 physical-design: one form for the canvas callouts
    The callouts named cells in four different ways: by kind alone, by
    type, by Yosys instance name (meaningless to a reader), or by a mix,
    and the root buffer had a different name on Antenna than on Clock. Now
    each names the kind of thing, adds the type only where the step is
    about the type, and leaves instance names to the hover. A few wordings
    change to match: the timing paths read alike, the resized cell shows
    its old and new type, and explanations stay only where they are the
    step's finding.
2026-11-14 physical-design: Power callouts for both rails, in reading order
    Both stripes were labelled but only one rail, and the callouts sat in
    no particular order. A reader takes them top to bottom, so they now go
    from the top of the grid down (stripes, rails, a via stack), VPWR
    before VGND each time. The two rail callouts name the rails of one row,
    from above and below, which is how a cell meets them.
2026-11-14 physical-design: one outline style, the cells' thin border
    With cells bordered, the thick ink outlines used to pick out cells (the
    example nets' pins, the root buffer on Antenna, the timing paths) and
    the heavier strokes on route guides, the g-cell rings, the floorplan
    row and the GDS close-up no longer matched. Picked-out cells are now
    drawn in full colour with the usual border over the greyed context, and
    every outline is 1 px. Borders on greyed context are dimmed with their
    cells, so in the light theme the context no longer reads as a grid of
    outlines.
2026-11-14 physical-design: focus changes take the same short time on every step
    The change of focus took a quarter of the new step, so on long steps it
    dragged: entering Detail, the antenna diode stayed in colour for about
    3.5 s after the rest of Antenna's subject had gone. It now takes about
    0.8 s (a quarter of a short step at most), and the antenna route fades
    out over the same time, so what leaves the focus leaves together.
2026-11-14 physical-design: explain the routing crowding map, as a plain heatmap
    The per-g-cell picture at the end of Route appeared with no word in the
    panel, whose text describes a different measure (wires across each
    edge), and at most sizes its extremes were bare rings around numbers.
    The panel now says what it counts and that it is not the router's own
    measure; the busiest and quietest g-cells are named by callouts at
    every size; and the tile numbers go, leaving the shading (hover gives
    any tile's count).
2026-11-14 physical-design: example nets on Detail appear whole, with callouts beside them
    Each example net's wires were drawn piece by piece in the order the DEF
    stores them, which mixes layers and branches and is not the order they
    were made in; the router works region by region on all nets at once. A
    net now fades in whole. Its callout pointed at the middle of a guide,
    often empty space on this step, and could sit over the net: it now
    points at the nearest point on the wires, and on Route and Detail the
    callout takes the nearest place that covers none of the net's wires or
    guides.
2026-11-14 physical-design: timing callouts clear of the paths
    With fixed offsets the callouts on Timing could sit on the paths they
    name, covering stretches of the setup path's wires. They now take the
    nearest place that covers none of either path's cells or wires, as the
    example nets' callouts do.
2026-11-14 physical-design: IR drop keeps both nets, with a callout for each
    The VPWR drop faded out as VGND's came in, so the finished picture hid
    half the result while the panel quotes VPWR first; both now stay, on
    their alternating rails, and the readout ends with both nets' worst
    drops. The stripe callouts, the only ones worded as statements, go:
    the panel says the drop is least beside the stripes, and with both
    nets drawn the map shows it. The two worst-drop points are a row apart,
    so their boxes sit close by in different directions, one above to the
    left and one level to the left, and their leaders cannot be confused.
2026-11-14 physical-design: a GDS build-up that can be read, layer by layer
    The layers came in faster than their names could be read, the only
    pointer was the readout, and once the metals arrived nothing could be
    made out under them. Each layer now gets 3 s and a callout at the
    middle of one of its shapes near the close-up's flip-flop, while the
    layers beneath it are dimmed; it dims in turn just before the next, and
    at the end everything undims. The flip-flop is named first, in its own
    colour, and its outline stays throughout. The close-up is now the
    flip-flop nearest the core centre with a power stripe beside it, so
    met4, and via3 in the stripe's via stacks, are in view too. Metals are
    filled more str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
2026-11-14 physical-design: name the timing path for what it is, explain clock line widths, calm the zoomed-out GDS
    The legend called the drawn setup path the worst, but it is the worst
    flip-flop to flip-flop path; the worst overall starts at rst_n, as the
    panel says. The clock note now says what the line widths mean. And at
    low zoom every metal wire's 1 px outline merged into solid colour,
    burying the cells and making the stripes look hollow: outlines now fade
    out once wires are too narrow on screen to show both edges, leaving the
    translucent fills.
2026-11-14 physical-design: fixes from review of the callouts, pins and legend
    The review found callouts covering what they name: on GDS the boxes
    landed inside the flip-flop whose insides each layer is shown on, and
    on IR drop each box lay along its own net's worst strip. GDS boxes now
    keep outside the cell (above or below its edge if nothing nearer is
    clear) and their points stay clear of the legend and foot band; IR drop
    boxes avoid the worst strips. On a phone the single-pin names piled
    into each other, so below 10 px a pin they wait for zooming in, as the
    others do. And the legend no longer shows via stacks in focus on IR
    drop, where the veil hides them.
2026-11-14 physical-design: say why legalising cells flip top to bottom
    The animation flips cells upside down as they legalise, here and in
    the legalisations after Clock and Hold, but the panel only named the
    row orientations. A cell flips when it lands in a row of the other
    orientation, so its power rails line up with the row's.
2026-11-14 physical-design: a step button starts its step, as Next does
    Clicking a step fast-forwarded (or rewound) to its end, so a reader
    jumping to, say, Legalise saw the cells already in their rows and not
    the step itself; with reduced motion the same click landed at the
    start, so the page behaved two ways. A step is now always shown from
    its start: a jump forward fast-forwards to the start (at most 2.6 s)
    and plays the step, and going back starts the step afresh rather than
    playing it in reverse, which showed nothing useful and stuttered when
    leaving GDS. The glide into the GDS close-up waits for that step to
    begin. → or the scrubber still skip to the end.
2026-11-14 physical-design: timing paths traced pin to pin, with wires over cells and pin vias
    The paths' legs looked like one wire crossing itself: separate nets
    crossing on different layers, all in one colour. Each net now has a
    1 px outline in the background colour, drawn in path order, so a later
    net crossing an earlier one reads as over and under. The wires are
    drawn over the cells, as the metal lies, with the vias where they meet
    the path's cells. Showing those exposed a tracing fault: a net's route
    was traced from the first wire point inside one cell's box to the first
    inside the next, so it stopped short of both pins; it now runs from pin
    to pin. The overlap test for the timing callouts uses th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
2026-11-14 physical-design: a glossary in the panel, as popups on marked terms
    A reader who jumps to a step meets terms explained on earlier ones,
    and some (slack, setup, HPWL, the Nesterov in Nesterov placement) were
    explained nowhere. Thirty-five terms, chosen from the panels' own usage,
    are now marked at their first use in each step's panel (not on the step
    that introduces them); hovering, focusing or tapping one shows a
    one-line definition and a link to the step that introduces it. The
    marking is done when a panel is drawn, from one table, so the texts
    stay as written; the two inline glosses that duplicated the glossary,
    slew's "(transition time)" and FS's "(flipped about the x axis)", go.
2026-11-14 physical-design: the GDS step ends on the whole finished die
    The tutorial ended inside the close-up of one flip-flop, so its last
    picture was a few cells, and the whole tile was only a keypress away
    for those who read the note. After the finished close-up holds, the
    camera now goes back out to the whole die, as it went in (a jump with
    reduced motion), and a replay goes in again.
2026-11-14 physical-design: the whole die is drawn throughout GDS's zoom back out
    While the camera moves, the GDS layers are shown as the image drawn for
    the view before the move. Gliding out from the close-up, that image
    covered only the close-up, so the rest of the chip stayed bare until the
    camera stopped and the view was redrawn.
    The whole die is now drawn ahead, while the finished layers hold before
    the zoom out, and shown under the moving image; once the camera arrives
    it is the finished view, so the end needs no redraw.
2026-11-14 physical-design: scrubbing GDS moves the camera as playing would
    The GDS camera moved only on events, the glide in as the step starts and
    the glide out at its end, so scrubbing back after the zoom out stayed on
    the whole die instead of returning to the close-up the step is about.
    Scrubbing now puts the camera where playing has it at that moment, and
    playing on from within a glide finishes that glide.
2026-11-14 physical-design: the play bar's pause button takes a real click
    While a step played, the button's icon was rewritten on every frame. A
    click takes longer than a frame, so the icon pressed on was gone by the
    release, and Firefox (and Chromium, given a slow enough click) dropped
    the click: play worked, pause did not. The icon is now rewritten only
    when the state changes, as the panel's button already was.
2026-11-14 physical-design: greyed-out context is fainter in light mode
    On the light theme the greyed cells and wires stayed dark enough to
    compete with each step's subject. How far greyed context goes toward the
    core colour is now set per theme, further on the light one; dark keeps
    its value.
2026-11-14 physical-design: room for the legend is what a step ever shows
    The space kept above the die was measured with every legend entry at
    once, including entries for single steps that never appear together, so
    the die was smaller than it needed to be on every step. It is now the
    tallest legend any one step shows.
2026-11-14 physical-design: route guides are one highlight over whole g-cells
    The guides were drawn inset per layer and in layer colours, so lanes
    looked narrower than their g-cells and cells shared by several layers
    mixed into colours of their own. The router's guides cover whole
    g-cells, and the layers show better as wires on the detailed routing
    step, so guides are now one faint highlight, stronger on the dark theme,
    with the layer swatches first appearing where wires do.
2026-11-14 physical-design: Antenna shows the wires the check estimated
    The violation is found on wires OpenROAD estimates from the guides
    before any are routed: one per guide, from the centre of its first
    g-cell to the centre of its last. Drawing those, in layer colours, shows
    the met3 wire the ratio is about, which the callout now names as
    estimated. The root buffer's callout says the gates are at risk, the
    panel says the wire ends on transistor gates rather than "a gate", and
    the crowding map fades out over the cells instead of lingering in the
    gaps between them.
2026-11-14 physical-design: the antenna diode's callout says it was inserted
    "antenna diode" alone read as part of the design from the start; the
    diode is what the repair inserted, as the panel says.
2026-11-14 physical-design: GDS metals are outlined round their merged shape
    Each metal layer is drawn as one path of many overlapping rectangles:
    wire segments, via pads, and cell shapes cut into rectangles. Stroking
    it outlined every rectangle, adding edges inside the metal that no mask
    has, mostly nested boxes at the vias. The outline is now drawn from the
    merged shape only: stroked at twice the width on a scratch canvas, the
    fill erased from it, and the outer half that is left laid on the layer.
2026-11-14 physical-design: review fixes to Antenna, Detail, Clock and Route
    From reviewing the changes since the last push. The root buffer's
    estimated stub is on met1, the run's lowest routing layer, not li1, and
    both stubs run along x first, as OpenROAD builds them; so li1 leaves the
    Antenna legend and met1 joins it. Detail's note no longer points at an
    off-layer stretch the drawing cannot show; the fact moves to the panel.
    The clock dots sit where the lines end, so the legend calls them sinks,
    the note mentions them, and they shrink with the rows so a phone's flip-
    flops stay visible. On a phone the metal layers lead the legend, the
    g-cell callout keeps clear of its cell when zoomed in, and the ins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
2026-11-14 fpga: run the game on the iCEBreaker, with a VGA Pmod and the snap-off buttons
    The iCEBreaker is a common iCE40UP5K board, and with a 12-bit VGA Pmod and the snap-off
    board's three buttons it plays the full game without Tiny Tapeout's demo board. The game is
    unchanged; this adds the 12 MHz to 25.125 MHz PLL, the reset, and the pin mapping, with a
    simulation test of everything but the PLL and the pins, and a CI workflow that builds and
    tests it as the Tang Nano's does.
    The pins are for MuseLab's PMOD-VGA v1.1, and were found on a board: its schematic, like
    Digilent's Pmod VGA, has each connector's rows the other way round, which puts the sync on
    green and gives no picture. MuseLab's own exam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
    [breakout_vga.sv, icebreaker_top.v, tb_breakout_vga.sv]
2026-11-14 fpga: one workflow builds every board into one download
    Each board had its own workflow and artifact, and none of the zips said which commit it came
    from or carried a licence. Now one job builds all three boards and packages them into
    tiny-breakout-fpga-<short commit>: the bitstreams, their logs, the licences that go with them,
    and a README naming the commit and saying how to load each one.
    Tiny Tapeout's board gets a build of its own, as fpga/fabricfox, after the board it targets
    (the FabricFox, which tt_fpga.py builds for by default). Tiny Tapeout's action installed the
    latest tools on each run and needed workarounds to set and report the clock; the new build
    pins its tools like the other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
    [fabricfox_top.v]
